eez-open/dib-dcp405plus/KiCad/EEZ DIB DCP405plus.kicad_pcb

## KiCad design KiCad/EEZ DIB DCP405plus.kicad_pcb (2026-09-21)

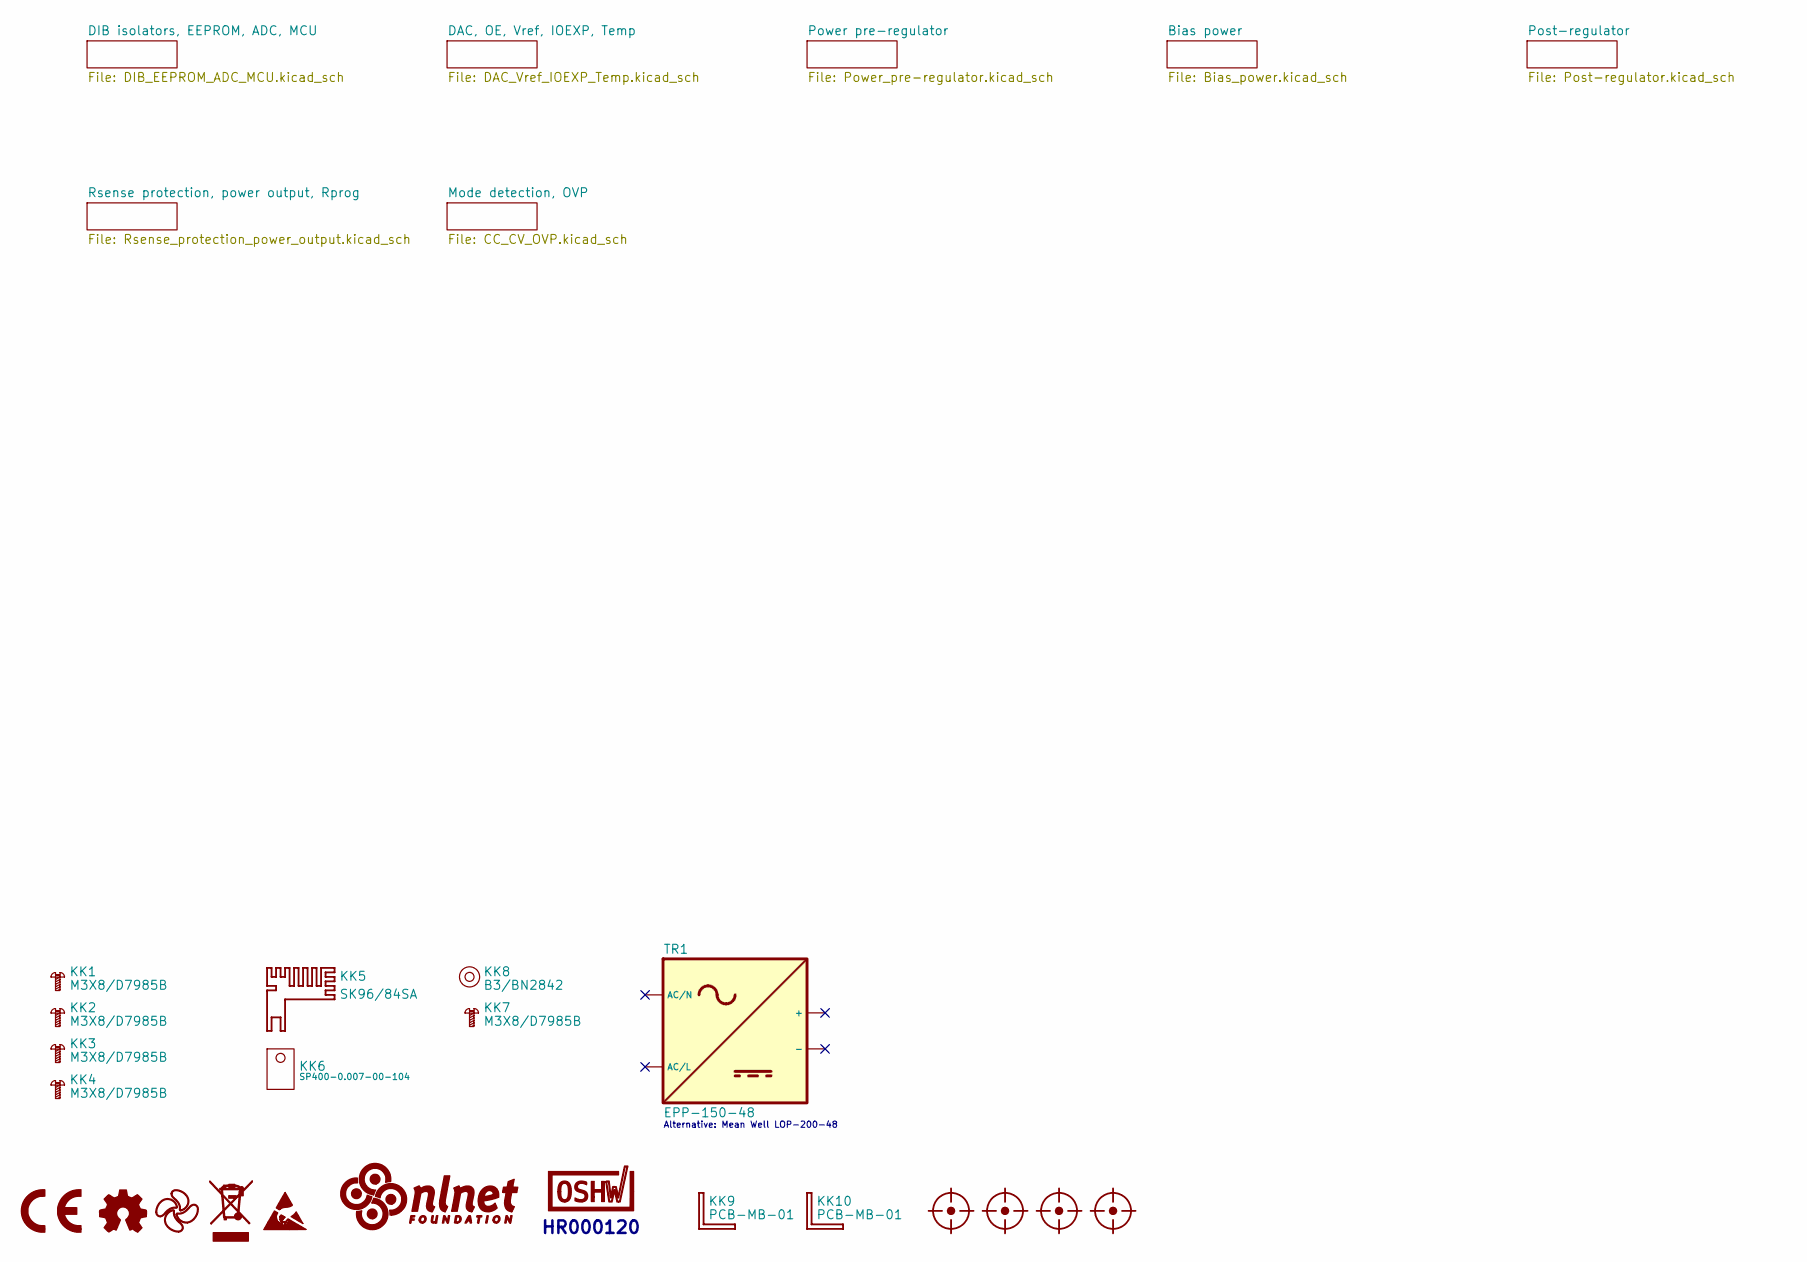
[picture p1: schematic EEZ DIB DCP405plus.kicad_sch, ${project_name}]

Parts:
FM1, FM2, FM3, FM4: FIDUCIAL; Fiducial_0.75mm_Mask1.5mm
KK1, KK2, KK3, KK4, KK7: M3X8/D7985B
KK5: SK96/84SA; SK96_84; DigiKey 5496-SK9684SA-ND
KK6: SP400-0.007-00-104; DigiKey BER204-ND
KK8: B3/BN2842
KK9, KK10: PCB-MB-01; DigiKey RPC1760-ND
LOGO1: CR logo; CE logo
LOGO2: Open HW logo
LOGO3: EEZ logo; EEZ logo (outline 6mm)
LOGO4: WEEE logo
LOGO5: ESD logo
LOGO6: NLnet logo
LOGO7: OSHWA logo; OSHWA logo 6.6mm
TR1: EPP-150-48; DigiKey 1866-1644-ND

Notes on the sheet:
Alternative: Mean Well LOP-200-48
HR000120

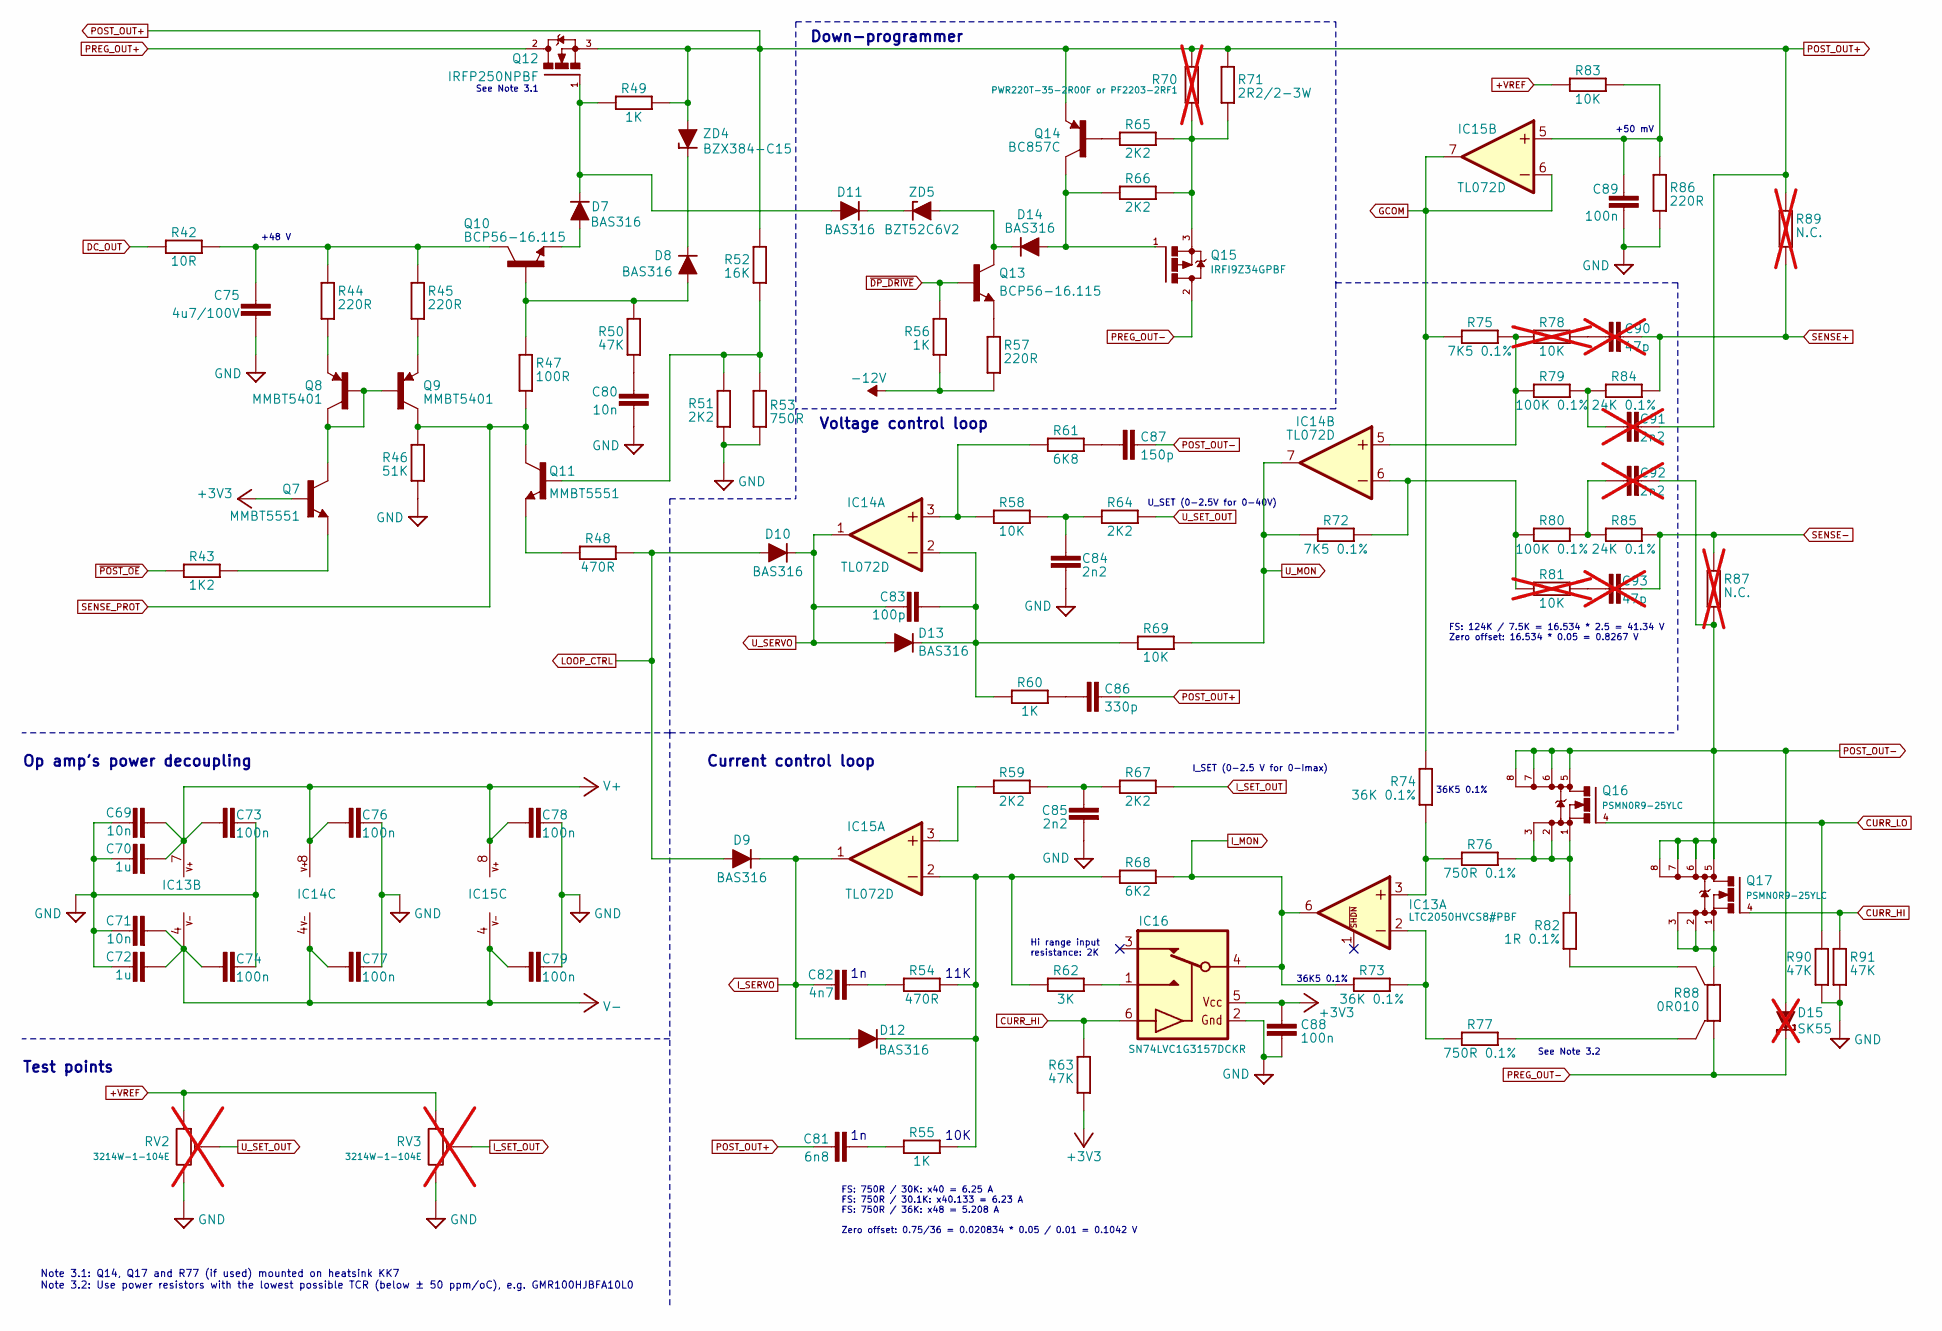
[picture p2: schematic Post-regulator.kicad_sch, ${project_name}]

Parts:
C69, C71, C80: 10n; C_0805_2012Metric; DigiKey 490-7194-1-ND
C70, C72: 1u; C_0805_2012Metric; DigiKey 587-1283-1-ND
C73, C74, C76, C77, C78, C79, C88, C89: 100n; C_0603_1608Metric; DigiKey 490-4774-1-ND
C75: 4u7/100V; C_1210_3225Metric; DigiKey 587-5034-1-ND
C81: 6n8; C_0805_2012Metric; DigiKey 1276-1799-1-ND
C82: 4n7; C_0805_2012Metric; DigiKey 732-12255-1-ND
C83: 100p; C_0805_2012Metric; DigiKey 399-15000-1-ND
C84, C85: 2n2; C_0805_2012Metric; DigiKey 399-C0805C222K5RAC7210TR-ND
C86: 330p; C_0805_2012Metric; DigiKey 1276-1189-1-ND
C87: 150p; C_0805_2012Metric; DigiKey 1276-1828-1-ND
C90, C93: 47p; C_0805_2012Metric; not fitted
C91, C92: 2n2; C_0805_2012Metric; DigiKey 399-C0805C222K5RAC7210TR-ND; not fitted
D7, D8, D9, D10, D11, D12, D13, D14: BAS316; SOD-323_1P8X1P35_ONS-M; DigiKey 1727-7370-1-ND
D15: SK55; DO214AA; DigiKey SK56A-LTPMSCT-ND; not fitted
IC13: LTC2050HVCS8#PBF; SOIC127P600X173-8N; DigiKey LTC2050HVCS8#PBF-ND
IC14, IC15: TL072D; SOIC127P600X173-8N; DigiKey 296-1282-1-ND
IC16: SN74LVC1G3157DCKR; SOT65P210X110-6N; DigiKey 296-14909-1-ND
Q7, Q11: MMBT5551; SOT23-BEC; DigiKey MMBT5551LT1GOSCT-ND
Q8, Q9: MMBT5401; SOT23-BEC; DigiKey MMBT5401-FDICT-ND
Q10, Q13: BCP56-16.115; SOT223-BCE; DigiKey BCP5616QTADICT-ND
Q12: IRFP250NPBF; TO247-3_SUNKEN; DigiKey IRFP250NPBF-ND
Q14: BC857C; SOT23-BEC; DigiKey 4878-BC857CCT-ND
Q15: IRFI9Z34GPBF; TO220FP-V; DigiKey IRFI9Z34GPBF-ND
Q16, Q17: PSMN0R9-25YLC; TDSON-8; DigiKey 1727-5292-1-ND
R42: 10R; R_0805_2012Metric; DigiKey YAG1320CT-ND
R43: 1K2; R_0805_2012Metric; DigiKey 311-1.20KCRCT-ND
R44, R45, R57, R86: 220R; R_0805_2012Metric; DigiKey RMCF0805FT220RCT-ND
R46: 51K; R_0805_2012Metric; DigiKey 311-51.0KCRCT-ND
R47: 100R; R_0603_1608Metric; DigiKey 13-RC0603FR-10100RLCT-ND
R48, R54: 470R; R_0805_2012Metric; DigiKey 311-470CRCT-ND
R49, R55, R56, R60: 1K; R_0805_2012Metric; DigiKey RC0805FR-071KL
R50, R63, R90, R91: 47K; R_0805_2012Metric; DigiKey RHM47KKCT-ND
R51, R59, R64, R65, R66, R67: 2K2; R_0805_2012Metric; DigiKey 311-2.20KCRCT-ND
R52: 16K; R_0805_2012Metric; DigiKey 311-16.0KCRCT-ND
R53: 750R; R_0805_2012Metric; DigiKey A126385CT-ND
R58, R69, R83: 10K; R_0805_2012Metric; DigiKey 311-10.0KCRCT-ND
R61: 6K8; R_0805_2012Metric; DigiKey 311-6.80KCRCT-ND
R62: 3K; R_0603_1608Metric; DigiKey 311-3.00KCRCT-ND
R68: 6K2; R_0805_2012Metric; DigiKey 311-6.20KCRCT-ND
R70: PWR220T-35-2R00F or PF2203-2RF1; TO220-2-V; DigiKey 696-1313-ND; not fitted
R71: 2R2/2-3W; R_2512_6332Metric; DigiKey CRM2512-JW-2R2ELFCT-ND
R72, R75: 7K5 0.1%; R_0805_2012Metric; DigiKey YAG1974CT-ND
R73, R74: 36K 0.1%; R_0805_2012Metric; DigiKey YAG4886CT-ND
R76, R77: 750R 0.1%; R_0805_2012Metric; DigiKey YAG4940CT-ND
R78, R81: 10K; R_0805_2012Metric; not fitted
R79, R80: 100K 0.1%; R_0805_2012Metric; DigiKey YAG4808CT-ND
R82: 1R 0.1%; R_1206_3216Metric; DigiKey 1712-CPF1206B1R0E1CT-ND
R84, R85: 24K 0.1%; R_0805_2012Metric; DigiKey P24KBFCT-ND
R87, R89: N.C.; R_0805_2012Metric; not fitted
R88: 0R010; R_2512-4WIRE; DigiKey 846-GMR100HJBFA10L0CT-ND
RV2, RV3: 3214W-1-104E; TRIM_3214W-1-104E; DigiKey 3214W-104ECT-ND; not fitted
ZD4: BZX384-C15; SOD-323_1P8X1P35_ONS-M; DigiKey 1727-4986-1-ND
ZD5: BZT52C6V2; SOD123; DigiKey 4878-BZT52C6V2CT-ND

Connections:
+3V3: C88.1, IC16.5 (VDD), Q7.B, R63.1; also elsewhere on the board
+VREF: R83.1, RV2.1, RV3.1; also elsewhere on the board
-12V: R56.2, R57.2; also elsewhere on the board
CURR_HI: IC16.6 (CTRL), Q17.4 (G), R63.2, R91.2; also elsewhere on the board
CURR_LO: Q16.4 (G), R90.2; also elsewhere on the board
DC_OUT: R42.2; also elsewhere on the board
GCOM: IC15.6 (-IN), IC15.7 (OUT), R74.1, R75.1; also elsewhere on the board
GND: C69.1, C70.1, C71.1, C72.1, C73.2, C74.2, C75.2, C76.1, C77.1, C78.1, C79.1, C80.2, C84.2, C85.2, C88.2, C89.2, IC16.2 (GND), R46.1, R51.1, R53.1, R86.2, R90.1, R91.1, RV2.3, RV3.3; also elsewhere on the board
I_MON: IC13.6 (OUT), IC16.4 (COM), R68.1, R73.2; also elsewhere on the board
I_SERVO: C82.2, D9.C, D12.A, IC15.1 (OUT); also elsewhere on the board
I_SET_OUT: R67.1, RV3.2; also elsewhere on the board
LOOP_CTRL: D9.A, D10.A, R48.1; also elsewhere on the board
unnamed: C75.1, Q10.C, R42.1, R44.2, R45.2
unnamed: C80.1, R50.1
unnamed: C81.2, R55.1
unnamed: C82.1, R54.1
unnamed: C84.1, R58.1, R64.2
unnamed: C85.1, R59.1, R67.2
unnamed: C86.2, R60.1
unnamed: C87.2, R61.1
unnamed: C90.2, R78.1
unnamed: C91.1, R79.2, R84.1
unnamed: C92.1, R80.2, R85.1
unnamed: C93.2, R81.1
unnamed: D7.A, Q10.E
unnamed: D8.A, Q10.B, R47.1, R50.2
unnamed: D8.C, ZD4.C
unnamed: D11.C, ZD5.C
unnamed: D14.C, Q13.C, ZD5.A
unnamed: IC13.3 (+IN), R74.2, R76.2
unnamed: IC13.2 (-IN), R73.1, R77.2
unnamed: IC14.3 (+IN), R58.2, R61.2
unnamed: C83.1, D13.C, IC14.2 (-IN), R60.2, R69.2
unnamed: IC14.5 (+IN), R75.2, R78.2, R79.1
unnamed: IC14.6 (-IN), R72.2, R80.1, R81.2
unnamed: IC15.3 (+IN), R59.2
unnamed: D12.C, IC15.2 (-IN), R54.2, R55.2, R62.2, R68.2
unnamed: C89.1, IC15.5 (+IN), R83.2, R86.1
unnamed: IC16.1 (NO), R62.1
unnamed: Q7.C, Q8.B, Q8.C, Q9.B
unnamed: Q7.E, R43.2
unnamed: Q8.E, R44.1
unnamed: Q9.E, R45.1
unnamed: Q11.B, R51.2, R52.1, R53.2
unnamed: Q11.E, R48.2
unnamed: D7.C, D11.A, Q12.1 (G), R49.1
unnamed: Q13.E, R57.1
unnamed: Q14.B, R65.2
unnamed: D14.A, Q14.C, Q15.1 (G), R66.2
unnamed: Q15.3 (S), R65.1, R66.1, R70.1, R71.2
unnamed: Q16.1 (S), Q16.2 (S), Q16.3 (S), R76.1, R82.2
unnamed: Q17.1 (S), Q17.2 (S), Q17.3 (S), R88.2
unnamed: R77.1, R88.1S
unnamed: R82.1, R88.2S
POST_OUT+: C81.1, C86.1, C91.2, Q12.3 (S), Q14.E, R49.2, R52.2, R70.2, R71.1, R89.1, ZD4.A; also elsewhere on the board
POST_OUT-: C87.1, C92.2, D15.A, Q16.5 (D), Q16.6 (S), Q16.7 (S), Q16.8 (S), Q17.5 (D), Q17.6 (S), Q17.7 (S), Q17.8 (S), R87.2; also elsewhere on the board
PREG_OUT+: Q12.2 (D); also elsewhere on the board
PREG_OUT-: D15.C, Q15.2 (D), R88.1; also elsewhere on the board
SENSE+: C90.1, R84.2, R89.2; also elsewhere on the board
SENSE-: C93.1, R85.2, R87.1; also elsewhere on the board
SENSE_PROT: Q9.C, Q11.C, R46.2, R47.2; also elsewhere on the board
U_MON: IC14.7 (OUT), R69.1, R72.1; also elsewhere on the board
U_SERVO: C83.2, D10.C, D13.A, IC14.1 (OUT); also elsewhere on the board
U_SET_OUT: R64.1, RV2.2; also elsewhere on the board
V+: C69.2, C70.2, C73.1, C76.2, C78.2, IC13.7 (V+), IC14.8 (V+), IC15.8 (V+); also elsewhere on the board
V-: C71.2, C72.2, C74.1, C77.2, C79.2, IC13.4 (V-), IC14.4 (V-), IC15.4 (V-); also elsewhere on the board
~DP_DRIVE: Q13.B, R56.1; also elsewhere on the board
~POST_OE: R43.1; also elsewhere on the board

Notes on the sheet:
Hi range input resistance: 2K
FS: 124K / 7.5K = 16.534 * 2.5 = 41.34 V Zero offset: 16.534 * 0.05 = 0.8267 V
11K
Down-programmer
+50 mV
I_SET (0-2.5 V for 0-Imax)
Op amp's power decoupling
See Note 3.1
36K5 0.1%
10K
Current control loop
Voltage control loop
See Note 3.2
+48 V
U_SET (0-2.5V for 0-40V)
Test points
FS: 750R / 30K: x40 = 6.25 A FS: 750R / 30.1K: x40.133 = 6.23 A FS: 750R / 36K: x48 = 5.208 A Zero offset: 0.75/36 = 0.020834 * 0.05 / 0.01 = 0.1042 V
Note 3.1: Q14, Q17 and R77 (if used) mounted on heatsink KK7 Note 3.2: Use power resistors with the lowest possible TCR (below ± 50 ppm/oC), e.g. GMR100HJBFA10L0

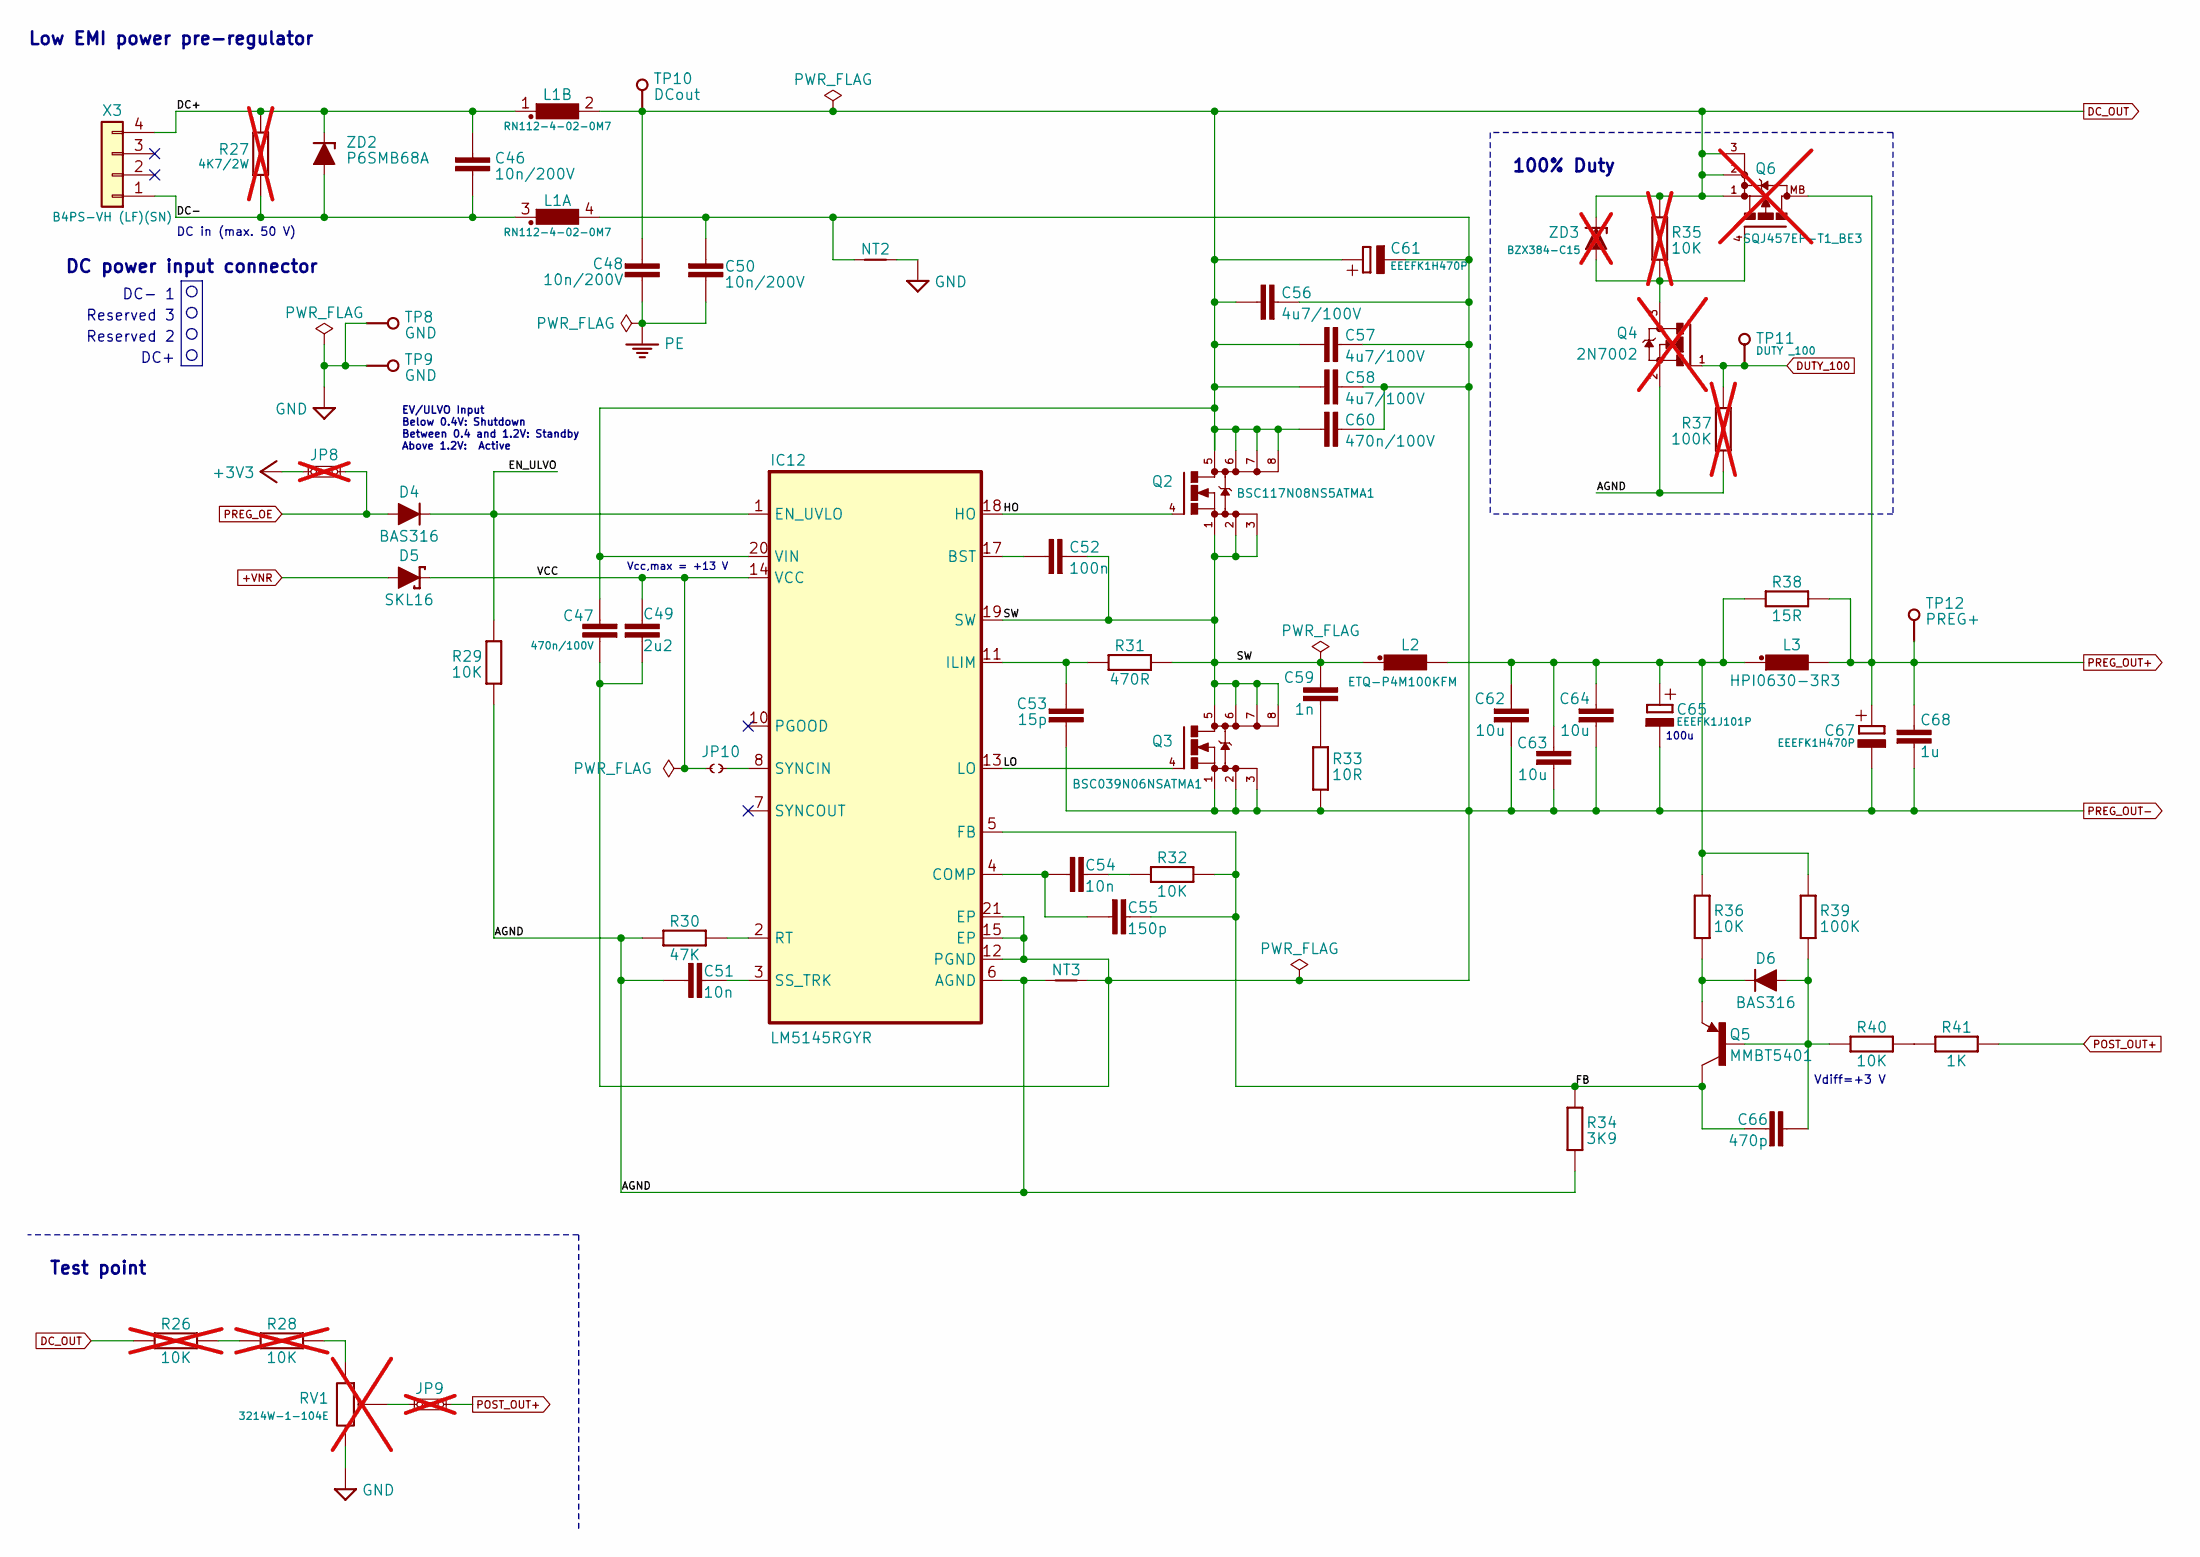
[picture p3: schematic Power_pre-regulator.kicad_sch, ${project_name}]

Parts:
C46, C48, C50: 10n/200V; C_1206_3216Metric; DigiKey 311-4491-1-ND
C47, C60: 470n/100V; C_0805_2012Metric; DigiKey 587-5014-1-ND
C49: 2u2; C_1206_3216Metric; DigiKey 1276-3138-1-ND
C51, C54: 10n; C_0805_2012Metric; DigiKey 490-7194-1-ND
C52: 100n; C_0603_1608Metric; DigiKey 490-4774-1-ND
C53: 15p; C_0603_1608Metric; DigiKey 399-C0603C150J5GAC7867TR-ND
C55: 150p; C_0805_2012Metric; DigiKey 1276-1828-1-ND
C56, C57, C58: 4u7/100V; C_1210_3225Metric; DigiKey 587-5034-1-ND
C59: 1n; C_0603_1608Metric; DigiKey 732-7858-1-ND
C61, C67: EEEFK1H470P; CAPAE830X1050N; DigiKey PCE3815CT-ND
C62, C63, C64: 10u; C_1210_3225Metric; DigiKey 1276-6736-1-ND
C65: EEEFK1J101P; CAPAE1030X1050N; DigiKey PCE3819CT-ND
C66: 470p; C_0805_2012Metric; DigiKey 732-7837-1-ND
C68: 1u; C_0805_2012Metric; DigiKey 587-1283-1-ND
D4, D6: BAS316; SOD-323_1P8X1P35_ONS-M; DigiKey 1727-7370-1-ND
D5: SKL16; SOD123; DigiKey RB160MM-60CT-ND
IC12: LM5145RGYR; RGY0020B; DigiKey 296-47661-1-ND
JP8, JP9: M22-2010246; DigiKey M22-2010346-ND; not fitted
JP10: JP2-CUT-0805; JP2 open (0603)
L1: RN112-4-02-0M7; RN112; DigiKey 817-2100-ND
L2: ETQ-P4M100KFM; PANASONIC_ETQ-P4_KFM; DigiKey P124167CT-ND
L3: HPI0630-3R3; COILCRAFT_HPI0630; DigiKey 445-180834-1-ND
NT2: NetTie_2; NetTie-2_SMD_Pad1.5mm
NT3: NetTie_2; NetTie-2_SMD_Pad0.2mm
Q2: BSC117N08NS5ATMA1; TDSON-8; DigiKey BSC117N08NS5ATMA1CT-ND
Q3: BSC039N06NSATMA1; TDSON-8; DigiKey BSC039N06NSATMA1CT-ND
Q4: 2N7002; SOT103P240X110-3N; DigiKey T2N7002AKLMCT-ND; not fitted
Q5: MMBT5401; SOT23-BEC; DigiKey MMBT5401-FDICT-ND
Q6: SQJ457EP-T1_BE3; PowerPAK SO-8; DigiKey 742-SQJ457EP-T1_BE3CT-ND; not fitted
R26, R28, R35: 10K; R_0805_2012Metric; DigiKey 311-10.0KCRCT-ND; not fitted
R27: 4K7/2W; R_2512_6332Metric; not fitted
R29, R32, R36, R40: 10K; R_0805_2012Metric; DigiKey 311-10.0KCRCT-ND
R30: 47K; R_0805_2012Metric; DigiKey RHM47KKCT-ND
R31: 470R; R_0805_2012Metric; DigiKey 311-470CRCT-ND
R33: 10R; R_0805_2012Metric; DigiKey YAG1320CT-ND
R34: 3K9; R_0805_2012Metric; DigiKey A126369CT-ND
R37: 100K; R_0805_2012Metric; DigiKey RMCF0805FT100KCT-ND; not fitted
R38: 15R; R_2010_5025Metric; DigiKey A129910CT-ND
R39: 100K; R_0805_2012Metric; DigiKey RMCF0805FT100KCT-ND
R41: 1K; R_0805_2012Metric; DigiKey RC0805FR-071KL
RV1: 3214W-1-104E; TRIM_3214W-1-104E; DigiKey 3214W-104ECT-ND; not fitted
TP8, TP9: PCB_TEST_TABSHIELD; Testhole 24_50mils
TP10, TP11, TP12: TEST-PIN_0.9MM; Testhole 24_50mils
X3: B4PS-VH (LF)(SN); B4PS-VH; DigiKey 455-B4PS-VH-ND
ZD2: P6SMB68A; DO214AA; DigiKey P6SMB68ABBCT-ND
ZD3: BZX384-C15; SOD-323_1P8X1P35_ONS-M; DigiKey 1727-4986-1-ND; not fitted

Connections:
+3V3: JP8.1; also elsewhere on the board
+VNR: D5.A; also elsewhere on the board
/Power pre-regulator/AGND: C51.2, IC12.6 (AGND), NT3.1, Q4.2 (S), R29.1, R30.1, R34.2, R37.2
/Power pre-regulator/DC+: C46.2, L1.1, R27.1, X3.4, ZD2.C
/Power pre-regulator/DC-: C46.1, L1.3 (1), R27.2, X3.1, ZD2.A
/Power pre-regulator/EN_ULVO: D4.C, IC12.1 (EN_UVLO), R29.2
/Power pre-regulator/FB: C55.1, C66.1, IC12.5 (FB), Q5.C, R32.2, R34.1
/Power pre-regulator/HO: IC12.18 (HO), Q2.4 (G)
/Power pre-regulator/LO: IC12.13 (LO), Q3.4 (G)
/Power pre-regulator/SW: C52.2, C59.1, IC12.19 (SW), L2.1, Q2.1 (S), Q2.2 (S), Q2.3 (S), Q3.5 (D), Q3.6 (S), Q3.7 (S), Q3.8 (S), R31.2
/Power pre-regulator/VCC: C49.2, D5.C, IC12.14 (VCC), JP10.1
DC_OUT: C47.2, C48.2, C56.1, C57.1, C58.1, C60.2, C61.+, IC12.20 (VIN), L1.2, Q2.5 (D), Q2.6 (S), Q2.7 (S), Q2.8 (S), Q6.1 (S), Q6.2 (S), Q6.3 (S), R26.2, R35.2, TP10.1 (P$1_1), ZD3.C; also elsewhere on the board
DUTY_100: Q4.1 (G), R37.1, TP11.1 (P$1_1); also elsewhere on the board
GND: NT2.2, RV1.3, TP8.1 (P$1_1), TP9.1 (P$1_1); also elsewhere on the board
unnamed: C54.1, R32.1
unnamed: C59.2, R33.2
unnamed: C62.1, C63.1, C64.1, C65.+, L2.2, L3.1, R36.1, R38.2, R39.1
unnamed: C66.2, D6.A, Q5.B, R39.2, R40.1
unnamed: D6.C, Q5.E, R36.2
unnamed: C52.1, IC12.17 (BST)
unnamed: C54.2, C55.2, IC12.4 (COMP)
unnamed: C53.1, IC12.11 (ILIM), R31.1
unnamed: IC12.2 (RT), R30.2
unnamed: C51.1, IC12.3 (SS_TRK)
unnamed: IC12.8 (SYNCIN), JP10.2
unnamed: JP9.1, RV1.2
unnamed: Q4.3 (D), Q6.4 (G), R35.1, ZD3.A
unnamed: R26.1, R28.2
unnamed: R28.1, RV1.1
unnamed: R40.2, R41.1
PE: C48.1, C50.2; also elsewhere on the board
POST_OUT+: JP9.2, R41.2; also elsewhere on the board
PREG_OE: D4.A, JP8.2; also elsewhere on the board
PREG_OUT+: C67.+, C68.2, L3.2, Q6.MB, R38.1, TP12.1 (P$1_1); also elsewhere on the board
PREG_OUT-: C47.1, C49.1, C50.1, C53.2, C56.2, C57.2, C58.2, C60.1, C61.-, C62.2, C63.2, C64.2, C65.-, C67.-, C68.1, IC12.12 (PGND), IC12.15 (EP), IC12.21 (EP), L1.4 (2), NT2.1, NT3.2, Q3.1 (S), Q3.2 (S), Q3.3 (S), R33.1; also elsewhere on the board

Notes on the sheet:
DC- 1
Reserved 2
Low EMI power pre-regulator
DC+
Vcc,max = +13 V
Reserved 3
DC in (max. 50 V)
100% Duty
Vdiff=+3 V
Test point
DC power input connector
100u
EV/ULVO Input Below 0.4V: Shutdown Between 0.4 and 1.2V: Standby Above 1.2V: Active

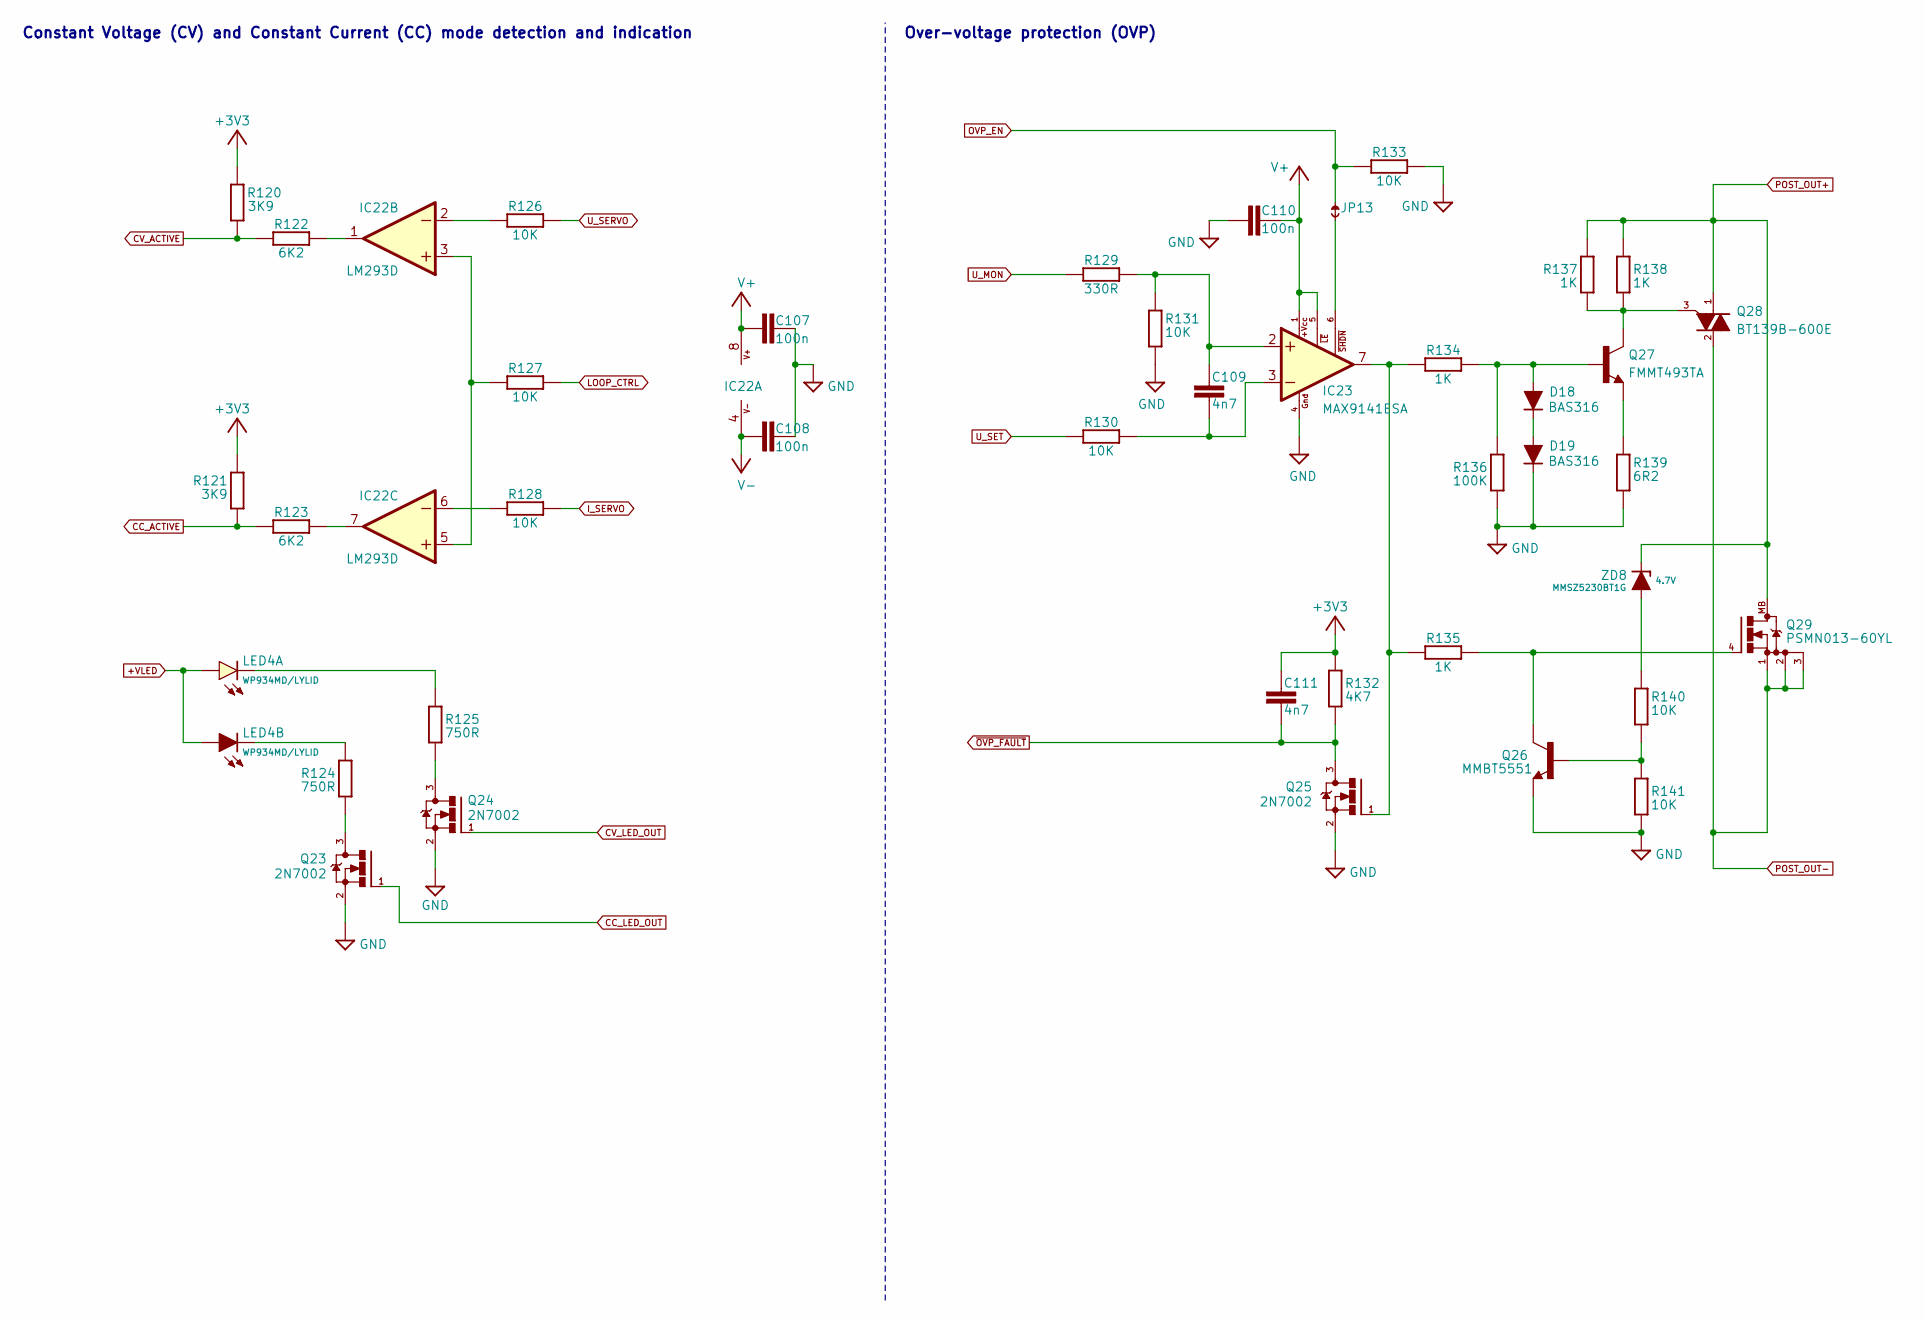
[picture p4: schematic CC_CV_OVP.kicad_sch, ${project_name}]

Parts:
C107, C108, C110: 100n; C_0603_1608Metric; DigiKey 490-4774-1-ND
C109, C111: 4n7; C_0805_2012Metric; DigiKey 732-12255-1-ND
D18, D19: BAS316; SOD-323_1P8X1P35_ONS-M; DigiKey 1727-7370-1-ND
IC22: LM293D; SOIC127P600X173-8N; DigiKey LM293DR2GOSCT-ND
IC23: MAX9141ESA; SOIC127P600X173-8N; DigiKey MAX9141ESA+-ND
JP13: JP2-NOCUT-0805; JP2 shorted (0603)
LED4: WP934MD/LYLID; WP934MD_2YD; DigiKey 350-2716-ND
Q23, Q24, Q25: 2N7002; SOT103P240X110-3N; DigiKey T2N7002AKLMCT-ND
Q26: MMBT5551; SOT23-BEC; DigiKey MMBT5551LT1GOSCT-ND
Q27: FMMT493TA; SOT23-BEC; DigiKey FMMT493CT-ND
Q28: BT139B-600E; TO-263_SOT-404; DigiKey 1740-1053-1-ND
Q29: PSMN013-60YL; SOT669; DigiKey 1727-2589-1-ND
R120, R121: 3K9; R_0805_2012Metric; DigiKey A126369CT-ND
R122, R123: 6K2; R_0805_2012Metric; DigiKey 311-6.20KCRCT-ND
R124, R125: 750R; R_0805_2012Metric; DigiKey A126385CT-ND
R126, R127, R128, R130, R131, R133, R140, R141: 10K; R_0805_2012Metric; DigiKey 311-10.0KCRCT-ND
R129: 330R; R_0805_2012Metric; DigiKey A129743CT-ND
R132: 4K7; R_0805_2012Metric; DigiKey 311-4.70KCRCT-ND
R134, R135, R137, R138: 1K; R_0805_2012Metric; DigiKey RC0805FR-071KL
R136: 100K; R_0805_2012Metric; DigiKey RMCF0805FT100KCT-ND
R139: 6R2; R_0805_2012Metric; DigiKey 311-6.20CRCT-ND
ZD8: MMSZ5230BT1G; SOD123; DigiKey MMSZ5230BT1GOSCT-ND

Connections:
+3V3: C111.1, R120.2, R121.2, R132.1; also elsewhere on the board
+VLED: LED4.BA (A), LED4.TA (A); also elsewhere on the board
CC_ACTIVE: R121.1, R123.2; also elsewhere on the board
CC_LED_OUT: Q23.1 (G); also elsewhere on the board
CV_ACTIVE: R120.1, R122.2; also elsewhere on the board
CV_LED_OUT: Q24.1 (G); also elsewhere on the board
GND: C107.1, C108.1, C110.1, D19.C, IC23.4 (GND), Q23.2 (S), Q24.2 (S), Q25.2 (S), Q26.E, R131.2, R133.1, R136.1, R139.1, R141.1; also elsewhere on the board
I_SERVO: R128.1; also elsewhere on the board
LOOP_CTRL: R127.2; also elsewhere on the board
unnamed: D18.A, Q27.B, R134.1, R136.2
unnamed: D18.C, D19.A
unnamed: IC22.3 (+IN), IC22.5 (+IN), R127.1
unnamed: IC22.2 (-IN), R126.2
unnamed: IC22.1 (OUT), R122.1
unnamed: IC22.6 (-IN), R128.2
unnamed: IC22.7 (OUT), R123.1
unnamed: C109.1, IC23.2 (+IN), R129.2, R131.1
unnamed: C109.2, IC23.3 (-IN), R130.2
unnamed: IC23.7 (OUT), Q25.1 (G), R134.2, R135.2
unnamed: IC23.6 (~SHDN), JP13.2
unnamed: LED4.TC (C), R125.1
unnamed: LED4.BC (C), R124.2
unnamed: Q23.3 (D), R124.1
unnamed: Q24.3 (D), R125.2
unnamed: Q26.B, R140.1, R141.2
unnamed: Q27.E, R139.2
unnamed: Q27.C, Q28.3 (G), R137.1, R138.1
unnamed: Q26.C, Q29.4 (G), R135.1
unnamed: R140.2, ZD8.A
OVP_EN: JP13.1, R133.2; also elsewhere on the board
POST_OUT+: Q28.1 (A1), Q29.MB, R137.2, R138.2, ZD8.C; also elsewhere on the board
POST_OUT-: Q28.2 (A2), Q29.1 (S), Q29.2 (S), Q29.3 (S); also elsewhere on the board
U_MON: R129.1; also elsewhere on the board
U_SERVO: R126.1; also elsewhere on the board
U_SET: R130.1; also elsewhere on the board
V+: C107.2, C110.2, IC22.8 (V+), IC23.1 (+VCC), IC23.5 (~LE); also elsewhere on the board
V-: C108.2, IC22.4 (V-); also elsewhere on the board
~OVP_FAULT: C111.2, Q25.3 (D), R132.2; also elsewhere on the board

Notes on the sheet:
Constant Voltage (CV) and Constant Current (CC) mode detection and indication
Over-voltage protection (OVP)
