eez-open/dib-dcp405plus/KiCad/EEZ DIB DCP405plus.kicad_pcb

## KiCad design KiCad/EEZ DIB DCP405plus.kicad_pcb (continued)

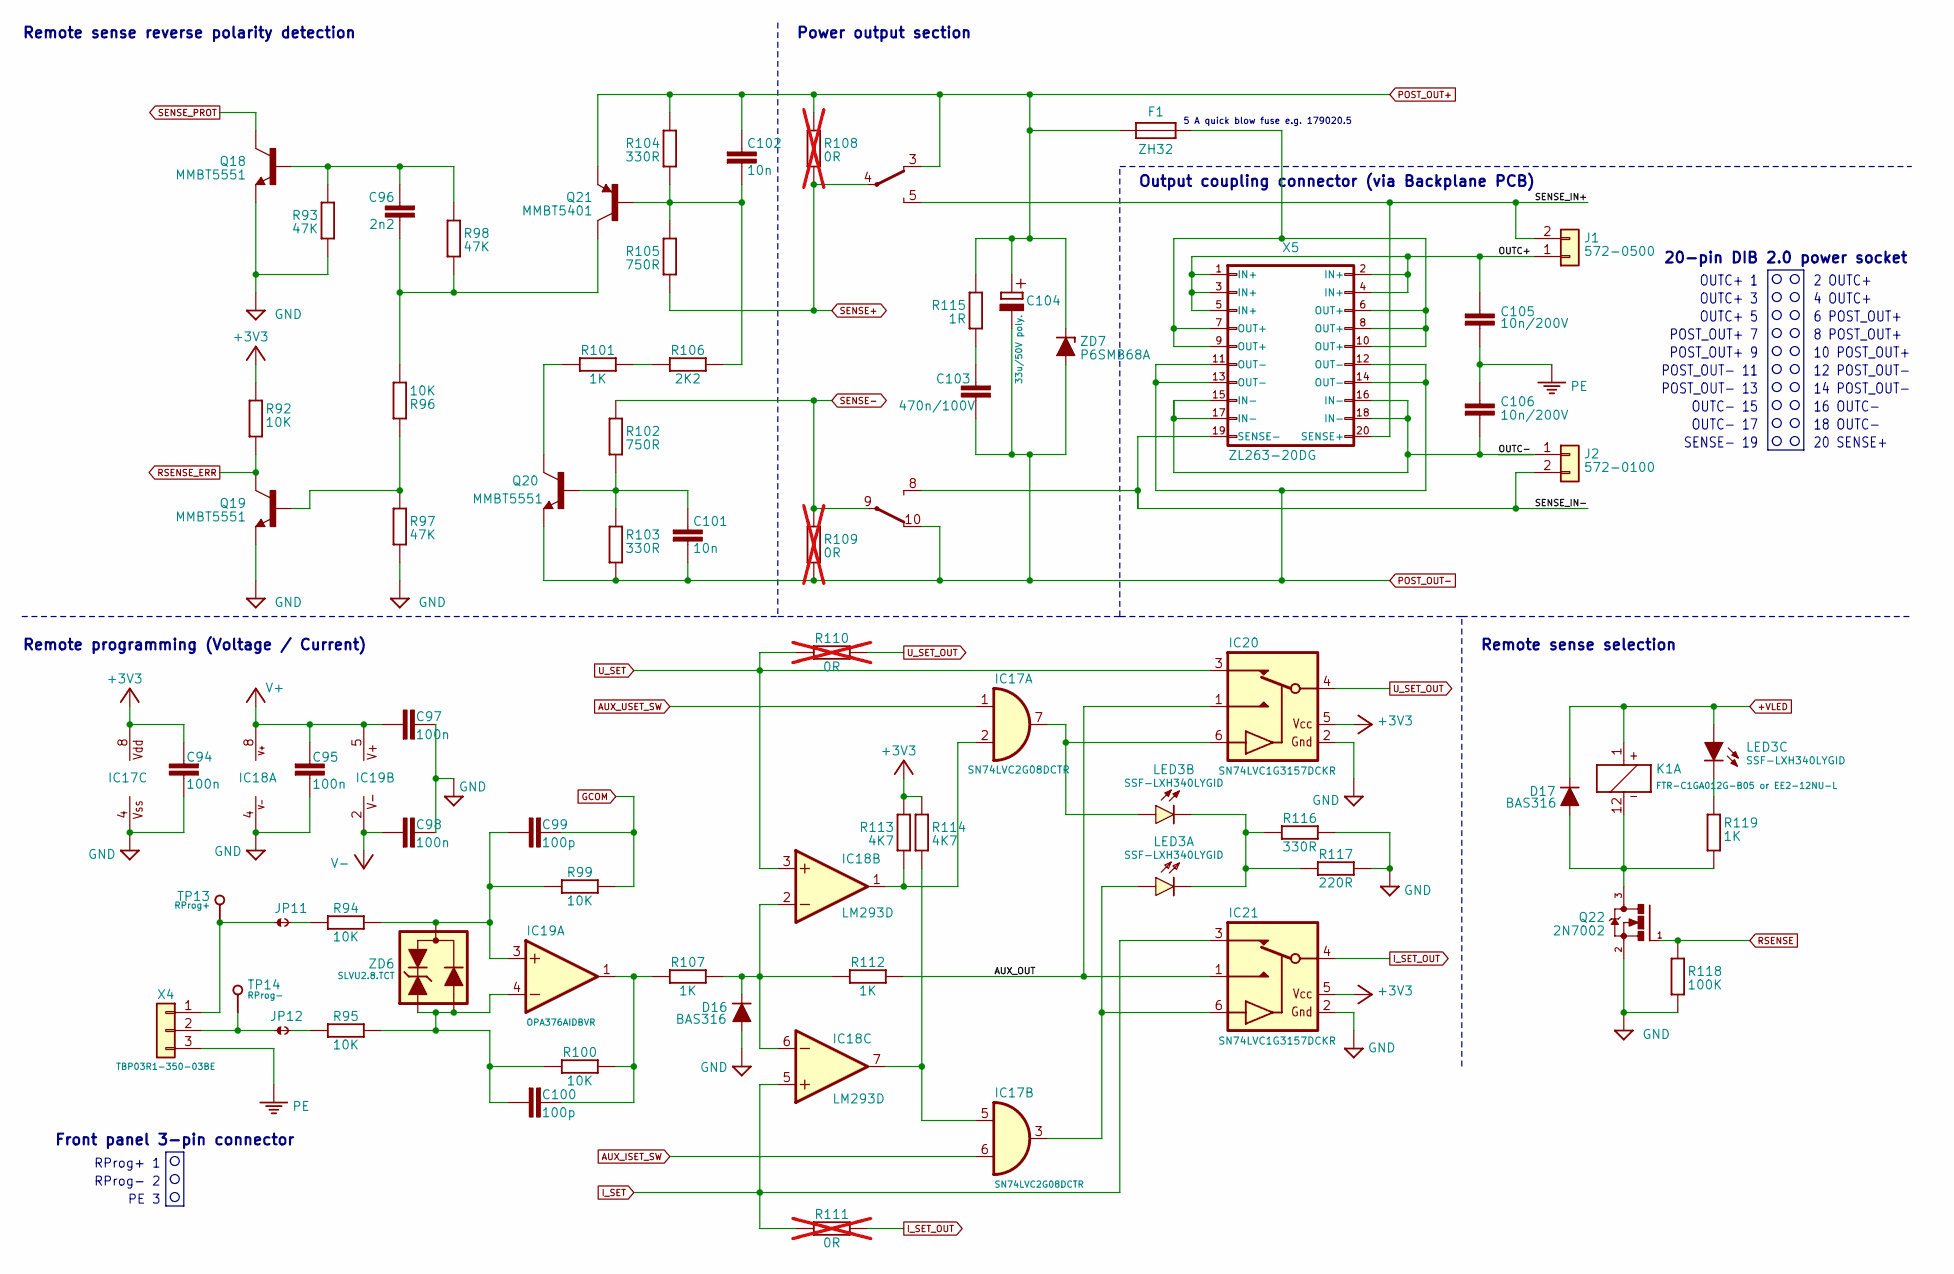
[picture p5: schematic Rsense_protection_power_output.kicad_sch, ${project_name}]

Parts:
C94, C95, C97, C98: 100n; C_0603_1608Metric; DigiKey 490-4774-1-ND
C96: 2n2; C_0805_2012Metric; DigiKey 399-C0805C222K5RAC7210TR-ND
C99, C100: 100p; C_0805_2012Metric; DigiKey 399-15000-1-ND
C101, C102: 10n; C_0805_2012Metric; DigiKey 490-7194-1-ND
C103: 470n/100V; C_0805_2012Metric; DigiKey 587-5014-1-ND
C104: 33u/50V poly.; CAPAE830X1050N; DigiKey 565-HHXD630ARA330MHA0GCT-ND
C105, C106: 10n/200V; C_1206_3216Metric; DigiKey 311-4491-1-ND
D16, D17: BAS316; SOD-323_1P8X1P35_ONS-M; DigiKey 1727-7370-1-ND
F1: ZH32; DigiKey 732-11370-ND
IC17: SN74LVC2G08DCTR; DCT8; DigiKey 296-13263-2-ND
IC18: LM293D; SOIC127P600X173-8N; DigiKey LM293DR2GOSCT-ND
IC19: OPA376AIDBVR; SOT23-5L_STM; DigiKey 296-39130-2-ND
IC20, IC21: SN74LVC1G3157DCKR; SOT65P210X110-6N; DigiKey 296-14909-1-ND
J1: 572-0500; Mouser 164-6221
J2: 572-0100; Mouser 164-6220
JP11, JP12: JP2-NOCUT-0805; JP2 shorted (0603)
K1: FTR-C1GA012G-B05 or EE2-12NU-L; FTR-C1; DigiKey 399-10997-1-ND
LED3: SSF-LXH340LYGID; DigiKey SSF-LXH340LYGID-ND
Q18, Q19, Q20: MMBT5551; SOT23-BEC; DigiKey MMBT5551LT1GOSCT-ND
Q21: MMBT5401; SOT23-BEC; DigiKey MMBT5401-FDICT-ND
Q22: 2N7002; SOT103P240X110-3N; DigiKey T2N7002AKLMCT-ND
R92, R94, R95, R96, R99, R100: 10K; R_0805_2012Metric; DigiKey 311-10.0KCRCT-ND
R93, R97, R98: 47K; R_0805_2012Metric; DigiKey RHM47KKCT-ND
R101, R107, R112, R119: 1K; R_0805_2012Metric; DigiKey RC0805FR-071KL
R102, R105: 750R; R_0805_2012Metric; DigiKey A126385CT-ND
R103, R104, R116: 330R; R_0805_2012Metric; DigiKey A129743CT-ND
R106: 2K2; R_0805_2012Metric; DigiKey 311-2.20KCRCT-ND
R108, R109, R110, R111: 0R; R_0603_1608Metric; not fitted
R113, R114: 4K7; R_0805_2012Metric; DigiKey 311-4.70KCRCT-ND
R115: 1R; R_0805_2012Metric; DigiKey 13-RC0805FR-131RLCT-ND
R117: 220R; R_0805_2012Metric; DigiKey RMCF0805FT220RCT-ND
R118: 100K; R_0805_2012Metric; DigiKey RMCF0805FT100KCT-ND
TP13, TP14: PCB_TEST_TABSHIELD; Testhole 24_50mils
X4: TBP03R1-350-03BE; DigiKey 2223-TBP03R1-350-03BE-ND
X5: ZL263-20DG; SSW-110-02-T-D-RA; DigiKey PPPC102LJBN-RC
ZD6: SLVU2.8.TCT; SOT23-3; DigiKey CDSOT23-SLVU2.8TR-ND
ZD7: P6SMB68A; DO214AA; DigiKey P6SMB68ABBCT-ND

Connections:
+3V3: C94.2, IC17.8 (VDD), IC20.5 (VDD), IC21.5 (VDD), R92.2, R113.1, R114.1; also elsewhere on the board
+VLED: D17.C, K1.1 (C1), LED3.YA; also elsewhere on the board
/Rsense protection, power output, Rprog/AUX_OUT: IC20.1 (NO), IC21.1 (NO), R112.1
/Rsense protection, power output, Rprog/OUTC+: C105.1, J1.1, X5.1 (IN+), X5.2 (IN+), X5.3 (IN+), X5.4 (IN+), X5.5 (IN+)
/Rsense protection, power output, Rprog/OUTC-: C106.2, J2.1, X5.15 (IN-), X5.16 (IN-), X5.17 (IN-), X5.18 (IN-)
/Rsense protection, power output, Rprog/SENSE_IN+: J1.2, K1.5 (NO), X5.20 (SENSE+)
/Rsense protection, power output, Rprog/SENSE_IN-: J2.2, K1.8 (NO), X5.19 (SENSE-)
AUX_ISET_SW: IC17.6 (I1); also elsewhere on the board
AUX_USET_SW: IC17.1 (I0); also elsewhere on the board
GCOM: C99.1, R99.1; also elsewhere on the board
GND: C94.1, C95.2, C97.2, C98.2, D16.A, IC17.4 (VSS), IC18.4 (V-), IC20.2 (GND), IC21.2 (GND), Q18.E, Q19.E, Q22.2 (S), R93.1, R97.1, R116.1, R117.1, R118.1; also elsewhere on the board
I_SET: IC18.5 (+IN), IC21.3 (NC), R111.2; also elsewhere on the board
I_SET_OUT: IC21.4 (COM), R111.1; also elsewhere on the board
unnamed: C96.1, Q18.B, R93.2, R98.2
unnamed: C96.2, Q21.C, R96.2, R98.1
unnamed: C101.1, Q20.B, R102.1, R103.2
unnamed: C102.2, Q21.B, R104.1, R105.2, R106.2
unnamed: C103.2, R115.2
unnamed: F1.2, X5.6 (OUT+), X5.7 (OUT+), X5.8 (OUT+), X5.9 (OUT+), X5.10 (OUT+)
unnamed: IC17.2 (I1), IC18.1 (OUT), R113.2
unnamed: IC17.7 (O), IC20.6 (CTRL), LED3.GA
unnamed: IC17.5 (I0), IC18.7 (OUT), R114.2
unnamed: IC17.3 (O), IC21.6 (CTRL), LED3.RA
unnamed: D16.C, IC18.2 (-IN), IC18.6 (-IN), R107.1, R112.2
unnamed: C99.2, IC19.3 (+IN), R94.1, R99.2, ZD6.3
unnamed: C100.2, IC19.4 (-IN), R95.1, R100.2, ZD6.1, ZD6.2
unnamed: C100.1, IC19.1 (OUT), R100.1, R107.2
unnamed: JP11.2, R94.2
unnamed: JP12.2, R95.2
unnamed: D17.A, K1.12 (C2), Q22.3 (D), R119.1
unnamed: LED3.GC, LED3.RC, R116.2, R117.2
unnamed: LED3.YC, R119.2
unnamed: Q19.B, R96.1, R97.2
unnamed: Q20.C, R101.1
unnamed: R101.2, R106.1
unnamed: JP11.1, TP13.1 (P$1_1), X4.1
unnamed: JP12.1, TP14.1 (P$1_1), X4.2
PE: C105.2, C106.1, X4.3; also elsewhere on the board
POST_OUT+: C102.1, C104.+, F1.1, K1.3 (NC), Q21.E, R104.2, R108.1, R115.1, ZD7.C; also elsewhere on the board
POST_OUT-: C101.2, C103.1, C104.-, K1.10 (NC), Q20.E, R103.1, R109.2, X5.11 (OUT-), X5.12 (OUT-), X5.13 (OUT-), X5.14 (OUT-), ZD7.A; also elsewhere on the board
RSENSE: Q22.1 (G), R118.2; also elsewhere on the board
RSENSE_ERR: Q19.C, R92.1; also elsewhere on the board
SENSE+: K1.4 (COM), R105.1, R108.2; also elsewhere on the board
SENSE-: K1.9 (COM), R102.2, R109.1; also elsewhere on the board
SENSE_PROT: Q18.C; also elsewhere on the board
U_SET: IC18.3 (+IN), IC20.3 (NC), R110.2; also elsewhere on the board
U_SET_OUT: IC20.4 (COM), R110.1; also elsewhere on the board
V+: C95.1, C97.1, IC18.8 (V+), IC19.5 (V+); also elsewhere on the board
V-: C98.1, IC19.2 (V-); also elsewhere on the board

Notes on the sheet:
8 POST_OUT+
PE 3
16 OUTC-
POST_OUT- 11
12 POST_OUT-
Remote sense reverse polarity detection
POST_OUT+ 9
OUTC- 17
Output coupling connector (via Backplane PCB)
POST_OUT- 13
Remote programming (Voltage / Current)
10 POST_OUT+
4 OUTC+
6 POST_OUT+
2 OUTC+
OUTC+ 5
14 POST_OUT-
18 OUTC-
POST_OUT+ 7
OUTC+ 1
RProg+ 1
20 SENSE+
Front panel 3-pin connector
OUTC+ 3
5 A quick blow fuse e.g. 179020.5
RProg- 2
Power output section
Remote sense selection
SENSE- 19
OUTC- 15
20-pin DIB 2.0 power socket

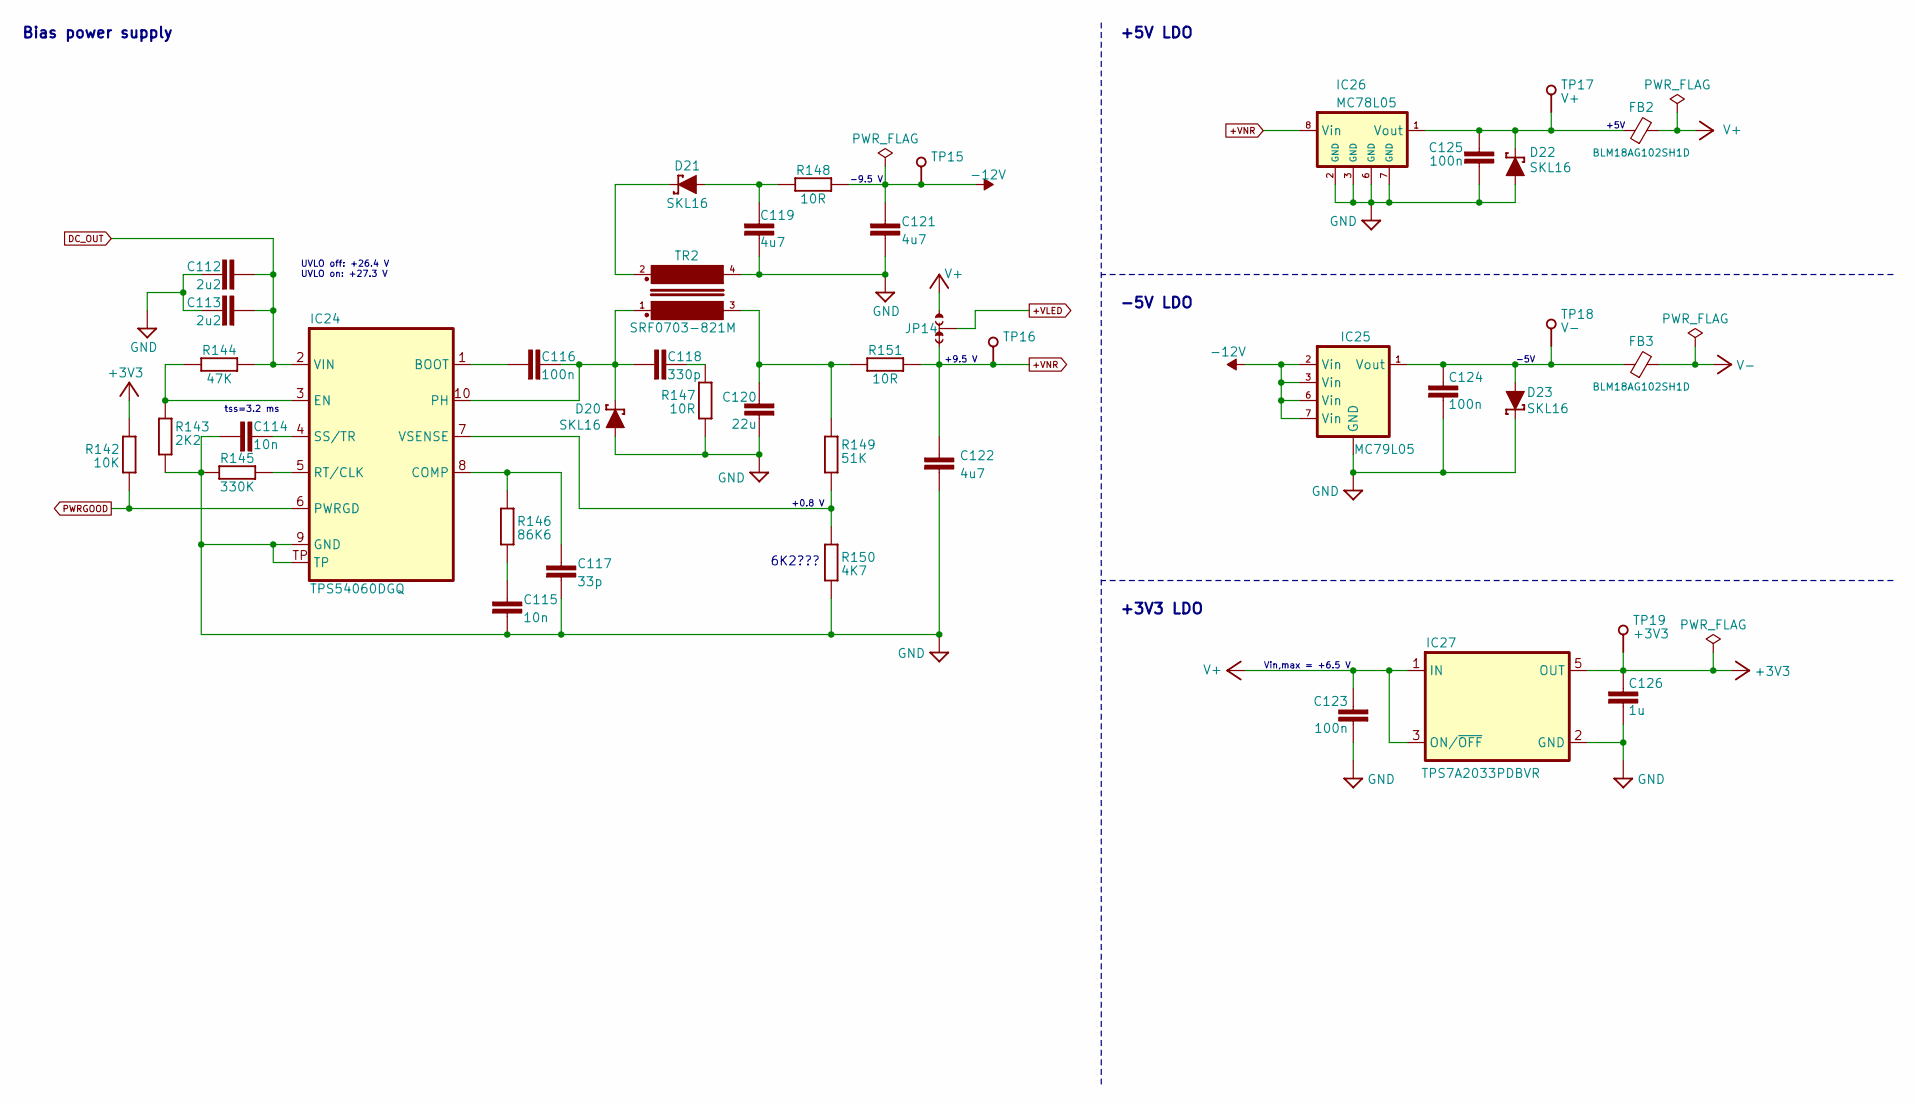
[picture p6: schematic Bias_power.kicad_sch, ${project_name}]

Parts:
C112, C113: 2u2; C_1206_3216Metric; DigiKey 1276-3138-1-ND
C114, C115: 10n; C_0805_2012Metric; DigiKey 490-7194-1-ND
C116, C123, C124, C125: 100n; C_0603_1608Metric; DigiKey 490-4774-1-ND
C117: 33p; C_0805_2012Metric; DigiKey 1276-1105-1-ND
C118: 330p; C_0805_2012Metric; DigiKey 1276-1189-1-ND
C119, C121, C122: 4u7; C_0805_2012Metric; DigiKey 1276-1244-1-ND
C120: 22u; C_1210_3225Metric; DigiKey 1276-1101-1-ND
C126: 1u; C_0805_2012Metric; DigiKey 587-1283-1-ND
D20, D21, D22, D23: SKL16; SOD123; DigiKey RB160MM-60CT-ND
FB2, FB3: BLM18AG102SH1D; BEAD0603; DigiKey 490-7809-1-ND
IC24: TPS54060DGQ; SOP50P490X110-11N; DigiKey 296-37148-1-ND
IC25: MC79L05; SOIC127P600X173-8N; DigiKey MC79L05ABDGOS-ND
IC26: MC78L05; SOIC127P600X173-8N; DigiKey MC78L05ACDR2GOSCT-ND
IC27: TPS7A2033PDBVR; SOT23-5L_STM; DigiKey 296-TPS7A2033PDBVRCT-ND
JP14: JP3 shorted (0603)
R142: 10K; R_0805_2012Metric; DigiKey 311-10.0KCRCT-ND
R143: 2K2; R_0805_2012Metric; DigiKey 311-2.20KCRCT-ND
R144: 47K; R_0805_2012Metric; DigiKey RHM47KKCT-ND
R145: 330K; R_0805_2012Metric; DigiKey A126361CT-ND
R146: 86K6; R_0805_2012Metric; DigiKey 311-86.6KCRCT-ND
R147, R148, R151: 10R; R_0805_2012Metric; DigiKey YAG1320CT-ND
R149: 51K; R_0805_2012Metric; DigiKey 311-51.0KCRCT-ND
R150: 4K7; R_0805_2012Metric; DigiKey 311-4.70KCRCT-ND
TP15, TP16, TP17, TP18, TP19: TEST-PIN_0.9MM; Testhole 24_50mils
TR2: SRF0703-821M; SRF0703; DigiKey SRF0703-821MCT-ND

Connections:
+3V3: C126.2, IC27.5 (OUT), R142.1, TP19.1 (P$1_1); also elsewhere on the board
+VLED: JP14.COM; also elsewhere on the board
+VNR: C122.1, IC26.8 (Vin), JP14.NC, R151.2, TP16.1 (P$1_1); also elsewhere on the board
-12V: C121.1, IC25.2 (Vin), IC25.3 (Vin), IC25.6 (Vin), IC25.7 (Vin), R148.2, TP15.1 (P$1_1); also elsewhere on the board
DC_OUT: C112.1, C113.1, IC24.2 (VIN), R144.2; also elsewhere on the board
GND: C112.2, C113.2, C114.2, C115.1, C117.1, C119.2, C120.2, C121.2, C122.2, C123.1, C124.1, C125.2, C126.1, D20.A, D22.A, D23.C, IC24.9 (GND), IC24.TP, IC25.5 (GND), IC26.2 (GND), IC26.3 (GND), IC26.6 (GND), IC26.7 (GND), IC27.2 (GND), R143.1, R145.1, R147.2, R150.2, TR2.4; also elsewhere on the board
unnamed: C115.2, R146.1
unnamed: C118.2, R147.1
unnamed: C119.1, D21.A, R148.1
unnamed: C120.1, R149.1, R151.1, TR2.3
unnamed: D21.C, TR2.2
unnamed: C116.2, IC24.1 (BOOT)
unnamed: C117.2, IC24.8 (COMP), R146.2
unnamed: IC24.3 (EN), R143.2, R144.1
unnamed: C116.1, C118.1, D20.C, IC24.10 (PH), TR2.1
unnamed: IC24.5 (RT/CLK), R145.2
unnamed: C114.1, IC24.4 (SS/TR)
unnamed: IC24.7 (VSENSE), R149.2, R150.1
unnamed: C124.2, D23.A, FB3.1, IC25.1 (Vout), TP18.1 (P$1_1)
unnamed: C125.1, D22.C, FB2.1, IC26.1 (Vout), TP17.1 (P$1_1)
PWRGOOD: IC24.6 (PWRGD), R142.2; also elsewhere on the board
V+: C123.2, FB2.2, IC27.1 (IN), IC27.3 (ON/~OFF), JP14.NO; also elsewhere on the board
V-: FB3.2; also elsewhere on the board

Notes on the sheet:
+5V
UVLO off: +26.4 V UVLO on: +27.3 V
Vin,max = +6.5 V
+5V LDO
Bias power supply
-5V LDO
+0.8 V
+3V3 LDO
6K2???
-5V
-9.5 V
tss=3.2 ms
+9.5 V

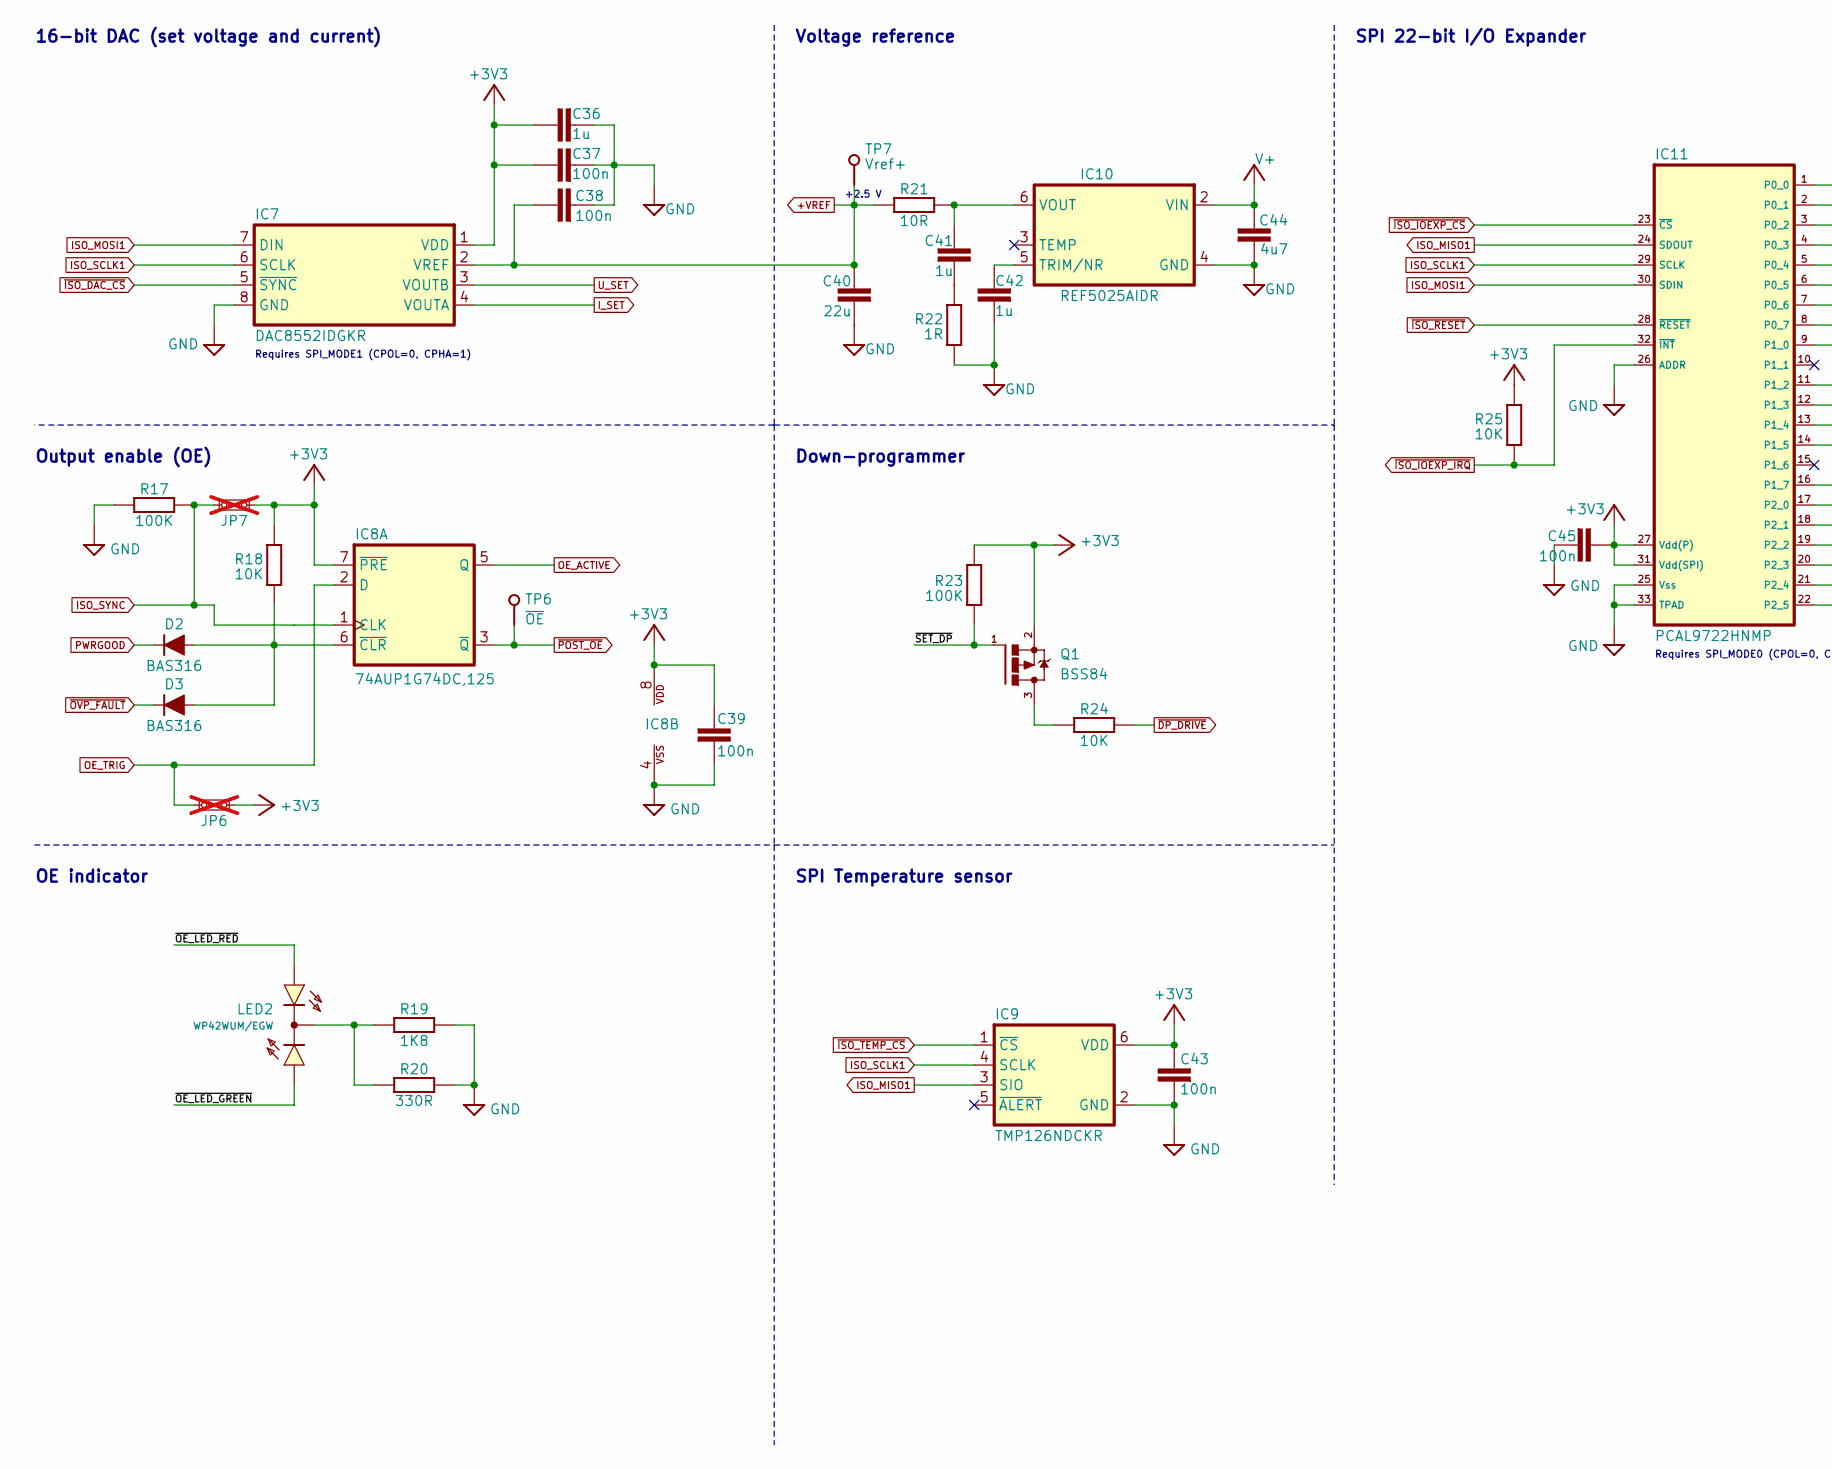
[picture p7: schematic DAC_Vref_IOEXP_Temp.kicad_sch, ${project_name}, part in row 1, column 1]

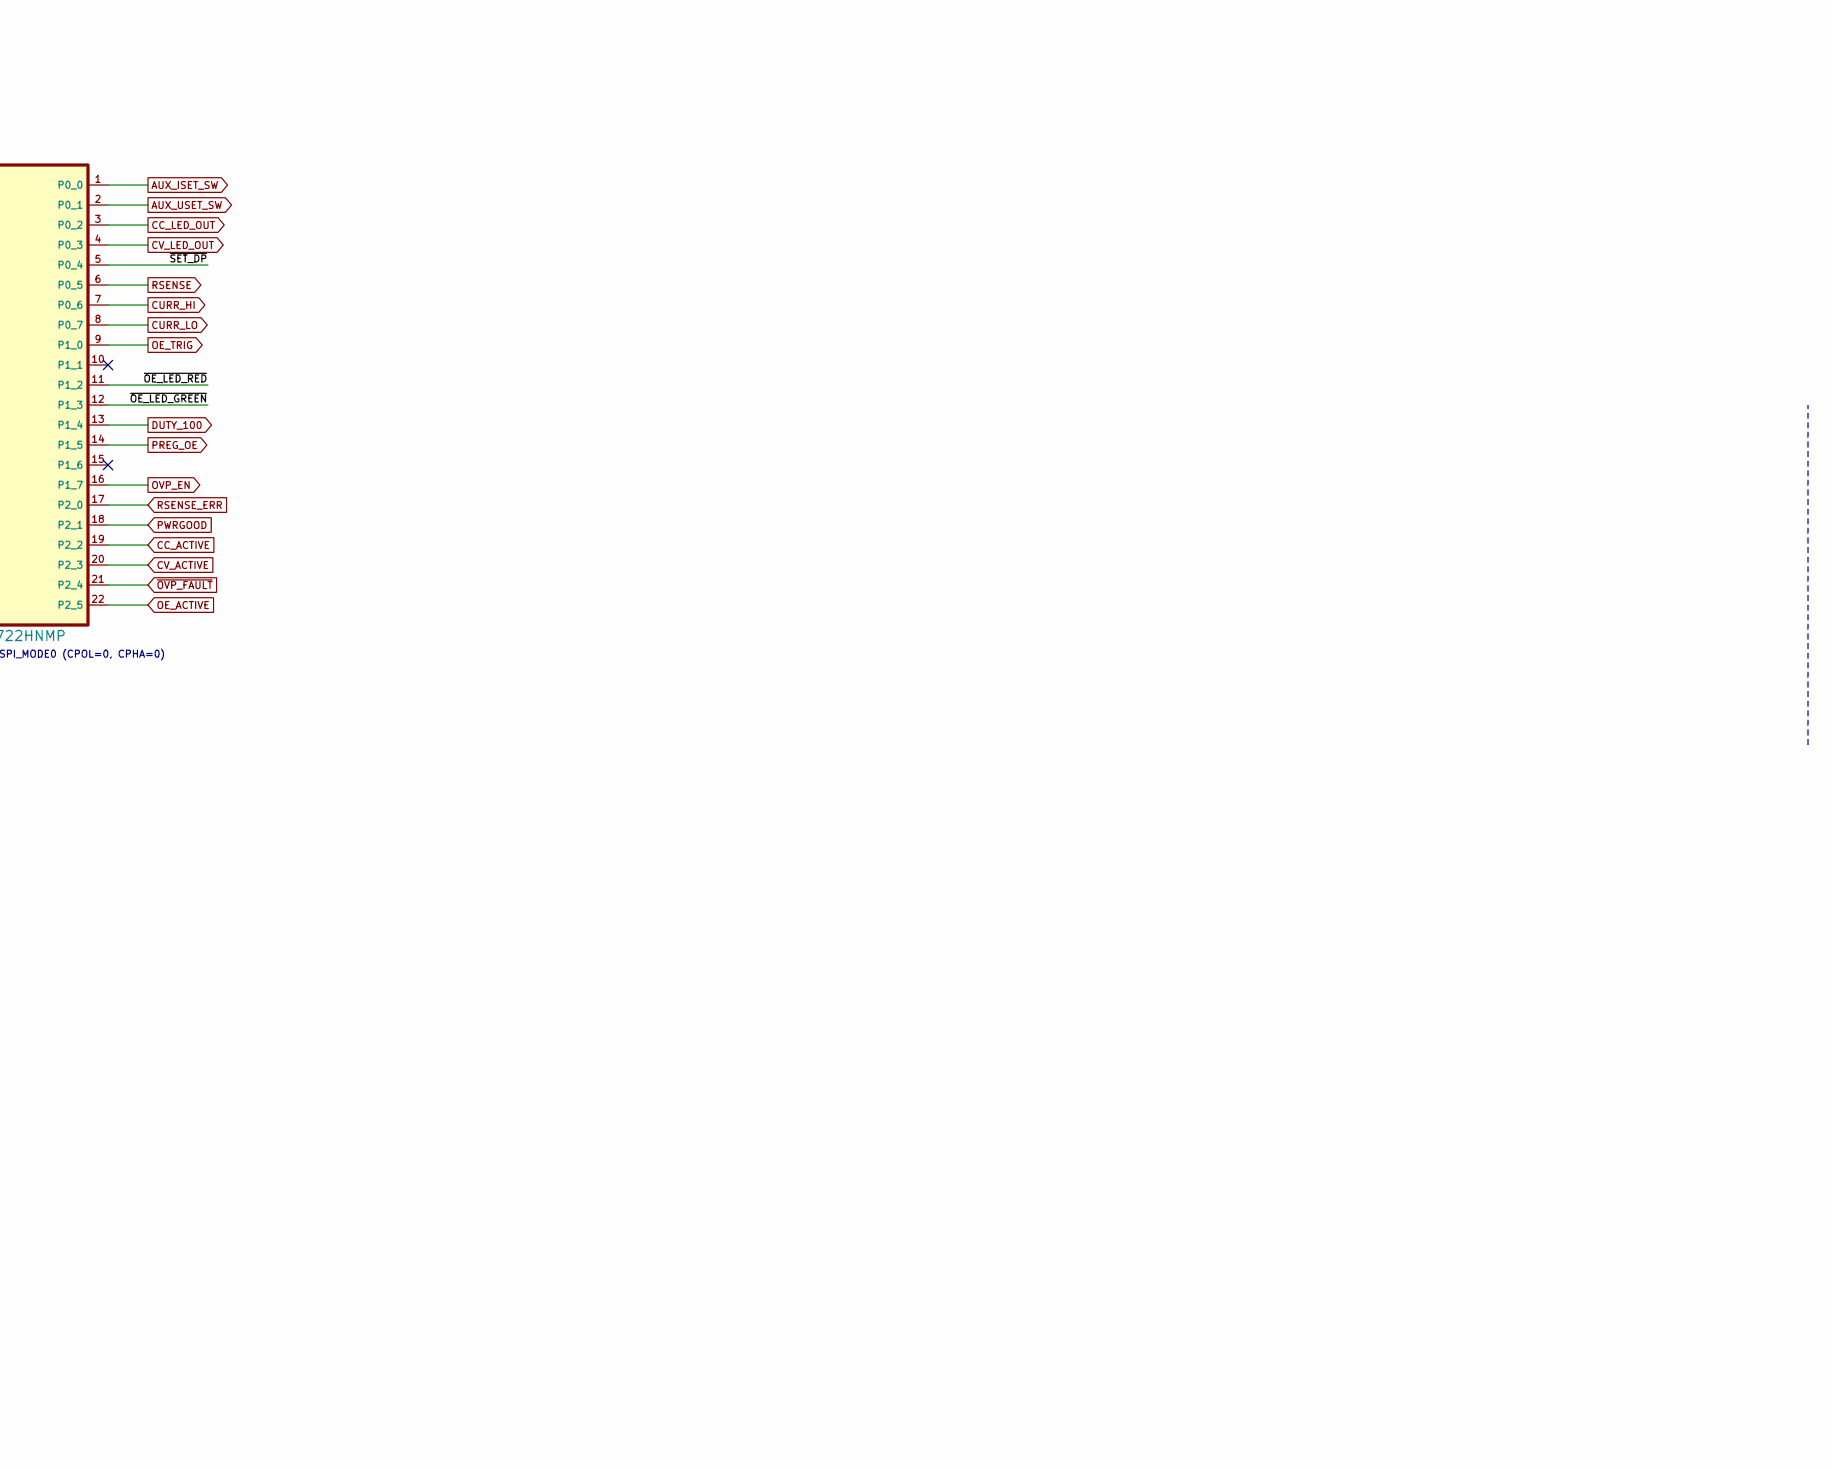
[picture p8: schematic DAC_Vref_IOEXP_Temp.kicad_sch, ${project_name}, part in row 1, column 2]

Parts:
C36, C41, C42: 1u; C_0805_2012Metric; DigiKey 587-1283-1-ND
C37, C38, C39, C43, C45: 100n; C_0603_1608Metric; DigiKey 490-4774-1-ND
C40: 22u; C_1210_3225Metric; DigiKey 1276-1101-1-ND
C44: 4u7; C_0805_2012Metric; DigiKey 1276-1244-1-ND
D2, D3: BAS316; SOD-323_1P8X1P35_ONS-M; DigiKey 1727-7370-1-ND
IC7: DAC8552IDGKR; DGK8-M; DigiKey 296-46082-1-ND
IC8: 74AUP1G74DC,125; DCU8; DigiKey 1727-6029-2-ND
IC9: TMP126NDCKR; DCK6; DigiKey 296-TMP126NDCKRCT-ND
IC10: REF5025AIDR; SOIC127P600X173-8N; DigiKey 296-39165-1-ND
IC11: PCAL9722HNMP; HVQFN32_SOT617-1_NXP-M; DigiKey 568-PCAL9722HNMPTR-ND
JP6, JP7: M22-2010246; DigiKey M22-2010346-ND; not fitted
LED2: WP42WUM/EGW; L-42WUM-1EGWT; DigiKey 754-1718-ND
Q1: BSS84; SOT103P240X110-3N; DigiKey BSS84LT1GOSCT-ND
R17, R23: 100K; R_0805_2012Metric; DigiKey RMCF0805FT100KCT-ND
R18, R24, R25: 10K; R_0805_2012Metric; DigiKey 311-10.0KCRCT-ND
R19: 1K8; R_0805_2012Metric; DigiKey 311-1.80KCRCT-ND
R20: 330R; R_0805_2012Metric; DigiKey A129743CT-ND
R21: 10R; R_0805_2012Metric; DigiKey YAG1320CT-ND
R22: 1R; R_0805_2012Metric; DigiKey 13-RC0805FR-131RLCT-ND
TP6: TEST-PIN_0.9MM; Testhole 24_50mils
TP7: PCB_TEST_TABSHIELD; Testhole 24_50mils

Connections:
+3V3: C36.1, C37.2, C39.2, C43.1, C45.2, IC7.1 (VDD), IC8.7 (~PRE), IC8.8 (VDD), IC9.6 (VDD), IC11.27 (Vdd(P)), IC11.31 (Vdd(SPI)), JP6.1, JP7.1, Q1.2 (S), R18.2, R23.1, R25.2; also elsewhere on the board
+VREF: C38.2, C40.1, IC7.2 (VREF), R21.1, TP7.1 (P$1_1); also elsewhere on the board
/DAC, OE, Vref, IOEXP, Temp/~OE_LED_GREEN: IC11.12 (P1_3), LED2.GREEN (AG)
/DAC, OE, Vref, IOEXP, Temp/~OE_LED_RED: IC11.11 (P1_2), LED2.RED (AR)
/DAC, OE, Vref, IOEXP, Temp/~SET_DP: IC11.5 (P0_4), Q1.1 (G), R23.2
AUX_ISET_SW: IC11.1 (P0_0); also elsewhere on the board
AUX_USET_SW: IC11.2 (P0_1); also elsewhere on the board
CC_ACTIVE: IC11.19 (P2_2); also elsewhere on the board
CC_LED_OUT: IC11.3 (P0_2); also elsewhere on the board
CURR_HI: IC11.7 (P0_6); also elsewhere on the board
CURR_LO: IC11.8 (P0_7); also elsewhere on the board
CV_ACTIVE: IC11.20 (P2_3); also elsewhere on the board
CV_LED_OUT: IC11.4 (P0_3); also elsewhere on the board
DUTY_100: IC11.13 (P1_4); also elsewhere on the board
GND: C36.2, C37.1, C38.1, C39.1, C40.2, C42.2, C43.2, C44.2, C45.1, IC7.8 (GND), IC8.4 (VSS), IC9.2 (GND), IC10.4 (GND), IC11.25 (Vss), IC11.26 (ADDR), IC11.33 (TPAD), R17.1, R19.2, R20.2, R22.2; also elsewhere on the board
ISO_MISO1: IC9.3 (SIO), IC11.24 (SDOUT); also elsewhere on the board
ISO_MOSI1: IC7.7 (DIN), IC11.30 (SDIN); also elsewhere on the board
ISO_SCLK1: IC7.6 (SCLK), IC9.4 (SCLK), IC11.29 (SCLK); also elsewhere on the board
ISO_SYNC: IC8.1 (CLK), JP7.2, R17.2; also elsewhere on the board
I_SET: IC7.4 (VOUTA); also elsewhere on the board
unnamed: C41.2, R22.1
unnamed: D2.A, D3.A, IC8.6 (~CLR), R18.1
unnamed: C42.1, IC10.5 (TRIM/NR)
unnamed: C41.1, IC10.6 (VOUT), R21.2
unnamed: LED2.CC (C), R19.1, R20.1
unnamed: Q1.3 (D), R24.2
OE_ACTIVE: IC8.5 (Q), IC11.22 (P2_5)
OE_TRIG: IC8.2 (D), IC11.9 (P1_0), JP6.2
OVP_EN: IC11.16 (P1_7); also elsewhere on the board
PREG_OE: IC11.14 (P1_5); also elsewhere on the board
PWRGOOD: D2.C, IC11.18 (P2_1); also elsewhere on the board
RSENSE: IC11.6 (P0_5); also elsewhere on the board
RSENSE_ERR: IC11.17 (P2_0); also elsewhere on the board
U_SET: IC7.3 (VOUTB); also elsewhere on the board
V+: C44.1, IC10.2 (VIN); also elsewhere on the board
~DP_DRIVE: R24.1; also elsewhere on the board
~ISO_DAC_CS: IC7.5 (~SYNC); also elsewhere on the board
~ISO_IOEXP_CS: IC11.23 (~CS); also elsewhere on the board
~ISO_IOEXP_IRQ: IC11.32 (~INT), R25.1; also elsewhere on the board
~ISO_RESET: IC11.28 (~RESET); also elsewhere on the board
~ISO_TEMP_CS: IC9.1 (~CS); also elsewhere on the board
~OVP_FAULT: D3.C, IC11.21 (P2_4); also elsewhere on the board
~POST_OE: IC8.3 (~Q), TP6.1 (P$1_1); also elsewhere on the board

Notes on the sheet:
Voltage reference
Requires SPI_MODE0 (CPOL=0, CPHA=0)
Down-programmer
Requires SPI_MODE1 (CPOL=0, CPHA=1)
Output enable (OE)
16-bit DAC (set voltage and current)
+2.5 V
SPI Temperature sensor
OE indicator
SPI 22-bit I/O Expander
