eez-open/dib-dcp405plus/(notices)

Notices in the files:
parts and their libraries:
project_license: Licensed under the TAPR Open Hardware License (www.tapr.org/OHL)
